pointlessaudio/PA_Telaio/hardware/prototipo-veroboard-seed3.html

# Prototipo su veroboard

Daisy Seed3 su zoccolo, due TLC2272 in DIP-8 a 9 V, ingresso e uscita stereo a livello strumento. Bypass in DSP su K1 e true bypass con footswitch 3PDT; i controlli sono cablati fuori scheda. Layout verificato da script: ogni net elettrica corrisponde a una sola isola di rame, nessun corto, nessun aperto.

Prima di saldare

1. Fai tutti i 57 tagli e controllali con il tester in continuità. Il taglio sulla colonna 7, righe 1–20, è quello che separa le due file del Seed: senza, il 3V3A va in corto con AGND e i 9 V finiscono su un GPIO.
2. Verifica sulla serigrafia del Seed3 dove sta il pin 1 e orienta gli header di conseguenza. Il puntino rosso nel disegno indica il pin 1.
3. Primo collaudo senza Seed e senza integrati negli zoccoli: misura VA, VB e VIN.

## Lato componenti

VA, alimentazione operazionali VB, bias a metà rail massa VIN Seed audio ponticello nudo taglio foro di fissaggio Ø 3,2

Strisce orizzontali viste in trasparenza. Linee continue: ponticelli sulla scheda, isolati tranne J1 e J2. Linee tratteggiate: cavetti isolati verso i pin del Seed, disegnati dritti per leggibilità: nella realtà falli girare intorno ai componenti. Cerchi verdi: piazzole per i fili che escono dalla scheda. Le resistenze che scavalcano una sola striscia vanno montate in piedi. D1 e R1 stanno sdraiati lungo la riga 22, a cavallo di un taglio.

## Lato rame, per i tagli

Vista dal lato rame, quindi specchiata: il foro 1 è a destra. I cerchi rossi sono i tagli, i fori chiari quelli dove va un terminale.

Fori di fissaggio, in blu nei due disegni: riga 2, fori 2 e 29; riga 38, foro 29; riga 44, foro 8. Da forare a 3,2 mm per viti M3, prima di montare i componenti. Stanno ad almeno un foro dal bordo e non spezzano strisce usate: layout.py lo controlla. Non usare la riga 45, l'ultima: la sua striscia porta la massa a R18 e alle masse delle uscite, e un foro lì sfonda il bordo.

Righe | Fori da tagliare | Perché
1–20 | 7, 15 | tra le due file del Seed, e accorcia le strisce di destra
22 | 5, 16 | isola jack DC, V9 e VIN
28–34 | 14 | centro dello zoccolo, separa canale sinistro e destro
37–44 | 14 | centro dello zoccolo, separa canale sinistro e destro

## Schema

### Alimentazione

### Ingresso, uno per canale

Tra parentesi i riferimenti del canale destro. Il guadagno è unitario: con una chitarra resti lontano dal fondo scala del Seed3, ma con 32 bit e il rumore di fondo del codec il margine perso non si sente.

### Uscita, una per canale

Lo stadio è invertente: in firmware moltiplica l'uscita per −1 per rimettere la fase in ordine.

## Componenti

Tipo | Valore | Q.tà | Riferimenti
Resistenza 1/4 W | 3R3 | 1 | R1
Resistenza 1/4 W | 10R | 1 | R2
Resistenza 1/4 W | 100R | 2 | R13, R17
Resistenza 1/4 W | 1K | 2 | R7, R10
Resistenza 1/4 W | 10K | 6 | R3, R4, R11, R12, R15, R16
Resistenza 1/4 W | 100K | 2 | R14, R18
Resistenza 1/4 W | 1M | 4 | R5, R6, R8, R9
Condensatore ceramico | 100pF | 2 | C19, C20
Condensatore ceramico | 390pF | 2 | C13, C16
Condensatore ceramico | 2.2nF | 2 | C6, C9
Condensatore ceramico | 100nF | 3 | C3, C11, C18
Condensatore a film | 100nF | 2 | C5, C8
Elettrolitico 16 V o più | 10µF | 6 | C7, C10, C12, C14, C15, C17
Elettrolitico 16 V o più | 47µF | 1 | C4
Elettrolitico 16 V o più | 100µF | 2 | C1, C2
Diodo Schottky | 1N5817 | 1 | D1
Operazionale DIP-8 | TLC2272 | 2 | U1, U2
Zoccolo | DIP-8 | 2 | U1, U2
Header femmina | 1×20, passo 2,54 | 2 | per il Seed3
Stripboard | almeno 30 fori × 45 strisce | 1
Jack 6,35 mm mono | boccola 3/8" | 4 | IN L e IN R con commutazione sulla punta; OUT L, OUT R
Jack DC 2,1 mm | centro negativo | 1
LED 3 mm + resistenza | 1K | 1 | fuori scheda, resistenza in linea
Filo isolato | unipolare 0,25 mm² | 1 | ponticelli J3-J13 e cavi W1-W7
Cavetto schermato | | 1 | ingressi e uscite verso i jack

## Cablaggio

### Piazzole verso l'esterno

Piazzola | Posizione | Cosa collegare
DC +9V | riga 22, foro 1 | Jack DC: +9 V (manicotto)
DC GND | riga 23, foro 1 | Jack DC: massa (centrale)
IN L | riga 32, foro 1 | Da Rs del jack IN L (INST/LINE)
IN L GND | riga 35, foro 1 | Jack IN L: manicotto
IN R | riga 34, foro 30 | Da Rs del jack IN R (INST/LINE)
IN R GND | riga 35, foro 30 | Jack IN R: manicotto
OUT L | riga 42, foro 1 | 3PDT polo A, posizione effetto
OUT L GND | riga 45, foro 1 | Jack OUT L: manicotto
OUT R | riga 42, foro 30 | 3PDT polo B, posizione effetto
OUT R GND | riga 45, foro 30 | Jack OUT R: manicotto
FS1 | riga 1, foro 1 | Tasto K1 (e pedale esterno, punta)
ENC A | riga 4, foro 1 | Encoder A
SD D0 | riga 5, foro 1 | microSD DAT0
SD CMD | riga 6, foro 1 | microSD CMD
SD CK | riga 7, foro 1 | microSD CLK
ENC B | riga 8, foro 1 | Encoder B
ENC SW | riga 9, foro 1 | Encoder pulsante
LED | riga 10, foro 1 | LED anodo tramite 1K
FS2 | riga 11, foro 1 | Tasto K2 (e pedale esterno, anello)
SCL | riga 12, foro 1 | OLED SCL
SDA | riga 13, foro 1 | OLED SDA
MIDI TX | riga 14, foro 1 | MIDI OUT verso scheda I/O
MIDI RX | riga 15, foro 1 | MIDI IN da scheda I/O
POT GND | riga 20, foro 3 | Pot 1-6: capo basso
CTRL GND | riga 1, foro 11 | Masse digitali: FS, encoder, LED
OLED GND | riga 1, foro 12 | OLED GND
IO GND | riga 1, foro 13 | Massa scheda I/O esterna
3V3D | riga 3, foro 13 | OLED VCC
IO 3V3D | riga 3, foro 14 | Alimentazione scheda I/O esterna
VA EXT | riga 37, foro 15 | VA verso schedina preamp e LED del bypass (R sul 3PDT); intrecciato con PRE GND
PRE GND | riga 35, foro 16 | Massa della schedina preamp, intrecciata con VA EXT
A5 | riga 14, foro 13 | Pot 6 cursore
A4 | riga 15, foro 13 | Pot 5 cursore
A3 | riga 16, foro 13 | Pot 4 cursore
A2 | riga 17, foro 13 | Pot 3 cursore
A1 | riga 18, foro 13 | Pot 2 cursore
A0 | riga 19, foro 13 | Pot 1 cursore
3V3A | riga 20, foro 13 | Pot 1-6: capo alto

### Ponticelli e cavetti

Nome | Riga/foro | Net
J1 | 28/12 → 29/12 | nudo
J2 | 29/17 → 30/17 | nudo
J3 | 28/18 → 25/18 | VA
J4 | 28/19 → 37/19 | VA
J5 | 31/5 → 35/5 | GND
J6 | 26/7 → 35/7 | GND
J7 | 23/29 → 26/29 | GND
J8 | 24/30 → 27/30 | VB
J9 | 27/29 → 36/29 | VB
J10 | 39/11 → 36/11 | VB
J11 | 40/21 → 36/21 | VB
J12 | 40/12 → 35/12 | GND
J13 | 40/2 → 45/2 | GND
W1 | 22/30 → 2/13 | VIN → pin 39
W2 | 23/2 → 20/2 | massa → AGND pin 20
W3 | 23/28 → 1/14 | massa → DGND pin 40
W4 | 34/1 → 16/1 | → IN 1 pin 16
W5 | 33/15 → 17/2 | → IN 2 pin 17
W6 | 44/1 → 18/1 | OUT 1 pin 18 →
W7 | 44/15 → 19/2 | OUT 2 pin 19 →

Encoder e tasti chiudono verso massa: attiva i pull-up interni in firmware. Le masse dei controlli digitali si uniscono fuori scheda e arrivano tutte alla piazzola CTRL.

## Scheda I/O posteriore e cablaggi esterni

Non è sulla veroboard: cablaggi per la schedina che porta MIDI, microSD, il deviatore INST/LINE e il jack pedale. Alimentazione dalle piazzole IO 3V3D / IO GND.

### MIDI IN — jack TRS 3,5 mm tipo A

Nodo | Collegato a
Anello (pin 4 DIN) | 220 Ω → anodo LED optoaccoppiatore H11L1M (pin 1)
Punta (pin 5 DIN) | catodo LED opto H11L1M (pin 2)
1N4148 | antiparallelo sul LED, catodo verso il pin 1
H11L1M pin 6 | +3V3D (piazzola IO 3V3D)
H11L1M pin 5 | GND (piazzola IO GND)
H11L1M pin 4 (uscita) | piazzola "MIDI RX", pull-up 270 Ω a +3V3D
100 nF | tra +3V3D e GND, vicino all'opto
Manica jack | GND tramite 100 nF, non diretto

Come da datasheet Seed3, fig. 7.1 e 7.3. L'opto isola la massa MIDI dalla massa audio; il diodo protegge il LED dalla polarità inversa del loop di corrente MIDI.

### MIDI OUT — jack TRS 3,5 mm tipo A

Nodo | Collegato a
Piazzola "MIDI TX" | 10 Ω → punta
+3V3D | 10 Ω → anello
Manica jack | GND

Come da datasheet Seed3, fig. 7.5: uscita a livello logico 3,3 V, senza opto, solo i due resistori di corrente.

### microSD, modalità 1-bit

Pin Seed | Pin scheda SD | Pull-up a +3V3D
D4 (piazzola "SD D0") | DAT0 | 47 kΩ
D5 (piazzola "SD CMD") | CMD | 47 kΩ
D6 (piazzola "SD CK") | CLK | nessuno
— (non collegato) | DAT1 | 47 kΩ
— (non collegato) | DAT2 | 47 kΩ
— (non collegato) | DAT3 | 47 kΩ

Come da datasheet Seed3, fig. 5.1. Alimentazione dalle piazzole IO 3V3D / IO GND. DAT1-DAT3 restano con pull-up sulla scheda SD ma non arrivano al Seed: modalità 1-bit, si leggono solo DAT0/CMD/CLK.

### Deviatore INST/LINE

DPDT sul pannello posteriore, un polo per canale. In serie tra la punta del jack d'ingresso e la piazzola IN L / IN R della scheda: Rs = 10 kΩ, sempre inserita. Dal lato scheda di Rs, Rsh = 3,3 kΩ verso GND attraverso il polo del deviatore.

Deviatore | Modo | Attenuazione | Impedenza d'ingresso
chiuso | LINE | −12 dB | ~13 kΩ
aperto | INST | 0 dB | ~1 MΩ

I due poli restano separati: un solo polo su entrambi i canali metterebbe in diafonia i due ingressi a deviatore aperto. Il jack d'ingresso deve avere il contatto di commutazione della punta verso GND, così a jack scollegato l'ingresso non fruscia.

### Jack TRS 6,35 mm "pedale"

In parallelo ai tasti K1 e K2 sul pannello (vedi Piazzole verso l'esterno, FS1/FS2): punta = D0 (K1, bypass), anello = D10 (K2, mono), manica = GND.

### True bypass stereo — footswitch 3PDT

Sul pannello superiore, in basso a destra. Due poli scambiano le uscite fra effetto e ingresso diretto, il terzo accende il LED accanto al footswitch. I nomi dei terminali seguono la funzione: sul 3PDT la fila centrale sono i comuni, le due file esterne le due posizioni.

Polo | Comune | Posizione "effetto" | Posizione "bypass"
A (sinistro) | punta jack OUT L | piazzola OUT L | punta jack IN L, prima di Rs
B (destro) | punta jack OUT R | piazzola OUT R | punta jack IN R, prima di Rs
C (LED) | VA tramite 4,7 kΩ saldata sul terminale | anodo LED bypass | libero

VA arriva dalla piazzola VA EXT; catodo del LED bypass alla massa più vicina (circa 1,5 mA con un LED rosso): acceso a effetto inserito. Come in case/cablaggio.md (29/10). In bypass l'ingresso resta collegato anche al buffer da 1 MΩ, che non carica il segnale; il deviatore INST/LINE agisce solo sul ramo effetto. R14/R18 da 100 kΩ tengono a massa i condensatori d'uscita: niente colpo alla commutazione. Il bypass in DSP su K1 resta, per gli effetti con code che devono sfumare. Il polo C porta VA (8,5 V): non collegarlo a un pin del Seed per leggere lo stato del 3PDT.

### Componenti fuori scheda

Tipo | Valore | Q.tà | Note
OLED I2C | 2,42", 128×64, SSD1309 | 1 | molti moduli escono in SPI: sposta il ponticello I2C sul modulo
Tasto tattile 12×12 | cappuccio tondo | 2 | K1, K2
Encoder | Bourns PEC11R | 1 | con pulsante
Potenziometro | Alpha 9 mm, 10K lineare | 6
Optoaccoppiatore | H11L1M | 1 | MIDI IN
Diodo | 1N4148 | 1 | MIDI IN, antiparallelo al LED
Resistenza | 220 Ω | 1 | MIDI IN, serie LED
Resistenza | 270 Ω | 1 | MIDI IN, pull-up uscita opto
Resistenza | 10 Ω | 2 | MIDI OUT
Resistenza | 47 kΩ | 5 | pull-up microSD: DAT0, DAT1, DAT2, DAT3, CMD
Resistenza | 10 kΩ | 2 | Rs deviatore INST/LINE, un canale ciascuna
Resistenza | 3,3 kΩ | 2 | Rsh deviatore INST/LINE, un canale ciascuna
Condensatore ceramico | 100 nF | 2 | decoupling opto, manica MIDI IN
Deviatore | DPDT | 1 | INST/LINE, pannello posteriore
Jack TRS 3,5 mm | | 2 | MIDI IN, MIDI OUT
Jack TRS 6,35 mm | | 1 | pedale esterno, in parallelo a K1/K2
Lettore microSD | | 1 | slot o modulo breakout
Footswitch | 3PDT, 9 terminali, boccola M12 | 1 | true bypass stereo, pannello superiore
LED | 3 mm | 1 | stato del bypass, accanto al footswitch
Resistenza | 1 kΩ | 1 | LED bypass, da +3V3D

## Collaudo

1. Continuità: ogni taglio aperto, nessun corto tra VA, VB, VIN e massa.
2. Alimenta a 9 V senza integrati e senza Seed. VA intorno a 8,6 V, VB metà di VA, VIN uguale a VA meno qualche decimo.
3. Inserisci U1 e U2. Le uscite dei quattro operazionali a riposo devono stare su VB.
4. Inserisci il Seed3 e carica un passthrough. Segnale in, segnale out, niente altro.
5. Solo dopo, collega pot, encoder, OLED, tasti e footswitch, uno alla volta.

## Limiti da conoscere

U1 e U2 sono TLC2272 al posto del TL072: il TL072 ha il modo comune d'ingresso che parte ~3 V sopra la massa, quindi l'inseguitore d'ingresso a VB ≈ 4,3 V arrivava solo a ~2,6 Vpp contro i 3,6 Vpp di fondo scala del codec; il TLC2272 accetta da 0 V a 1,5 V sotto il positivo, ~5,5 Vpp intorno a VB. Rumore 9 nV/√Hz, il doppio dell'OPA1652 dei circuiti del datasheet Seed3 (che è solo SMD): con una chitarra collegata domina il rumore dei pickup. Con una sorgente di linea molto calda il segnale può comunque superare il fondo scala del Seed3 attraverso il buffer a guadagno unitario: in quel caso metti un partitore prima di J IN.

Il rumore sarà peggiore di un PCB a quattro strati con piano di massa. Cavetto schermato su ingressi e uscite, fili dei pot corti e lontani dal Seed, e hai fatto quello che il veroboard permette.
