pointlessaudio/PA_Telaio/docs/storico/PA-TELAIO_BOM.xlsx

Rif. | Q.tà | Componente / Valore | Package | Sezione | Note
J1 | 1 | Jack DC 2.1 mm, center-negative, PCB | THT | Alimentazione | Tipo Boss, 9 V
D1 | 1 | NSR1020MW2T3G (Schottky) | SOD-323 | Alimentazione | Protezione inversione — datasheet Fig. 1.1
R1, R2 | 2 | 3R3, 1/4 W | THT | Alimentazione | Filtro serie rail — datasheet Fig. 1.1
C1-C4 | 4 | 100 uF elettrolitico, 25 V | THT | Alimentazione | Bulk 9V / 9V_A / VIN
C5, C6 | 2 | 100 nF X7R | 0805 | Alimentazione | Bypass
U1 | 1 | 78L05 | TO-92 | Alimentazione | Rail +5 V per expression, CV, relè
C7 | 1 | 10 uF elettrolitico | THT | Alimentazione | Ingresso 78L05
C8 | 1 | 100 nF X7R | 0805 | Alimentazione | Uscita 78L05
U2 | 1 | MCP6002 (dual) | SOIC-8 | Riferimento bias | Datasheet Fig. 3.1 — U2B libero su header
R3, R4 | 2 | 10K 1% | 0805 | Riferimento bias | Partitore da +9V_A
R5 | 1 | 10K | 0805 | Riferimento bias | Carico permanente uscita buffer
C9 | 1 | 10 uF | THT | Riferimento bias
C10 | 1 | 100 nF X7R | 0805 | Riferimento bias
C11 | 1 | 100 uF elettrolitico | THT | Riferimento bias
J2, J3 | 2 | Jack 6.3 mm mono switched, PCB | THT | Ingresso | IN L / IN R, R normalizzato su L
U3, U4 | 2 | OPA1652 (dual) | SOIC-8 | Ingresso | Uno per canale — datasheet Fig. 3.4
R6, R7 | 2 | 1M | 0805 | Ingresso | Impedenza ingresso 1 MΩ
R8, R9 | 2 | 100R | 0805 | Ingresso | Serie protezione
C12, C13 | 2 | 100 pF C0G | 0805 | Ingresso | Filtro RF
C14, C15 | 2 | 10 uF elettrolitico | THT | Ingresso | Accoppiamento ingresso
R10, R11 | 2 | 3K3 | 0805 | Ingresso | Filtro anti-alias
C16, C17 | 2 | 1 nF C0G | 0805 | Ingresso | Filtro anti-alias ~48 kHz
R12, R13 | 2 | 4K7 | 0805 | Ingresso
C18, C19 | 2 | 33 nF | 0805 | Ingresso
R14, R15 | 2 | 10K | 0805 | Ingresso | Rete secondo stadio
C20, C21 | 2 | 330 pF C0G | 0805 | Ingresso
R16, R17 | 2 | 100R | 0805 | Ingresso | Serie verso Audio In del Seed3
C22, C23 | 2 | 10 uF elettrolitico | THT | Ingresso | Accoppiamento verso Seed3
R18, R19 | 2 | 33K | 0805 | Ingresso | SCELTA DI PROGETTO — Rf guadagno, da tarare a banco
R20, R21 | 2 | 8K2 | 0805 | Ingresso | SCELTA DI PROGETTO — Rg, guadagno ~x5
SW1 | 1 | Toggle DPDT ON-ON | THT | Ingresso | Strumento / Linea, commuta entrambi i canali
U5 | 1 | OPA1652 (dual) | SOIC-8 | Uscita | Un op-amp per canale — datasheet Fig. 3.5
R22, R23 | 2 | 15K | 0805 | Uscita
R24, R25 | 2 | 33K | 0805 | Uscita
C24, C25 | 2 | 100 pF C0G | 0805 | Uscita
C26, C27 | 2 | 10 uF elettrolitico | THT | Uscita | Accoppiamento da Audio Out
C28, C29 | 2 | 10 uF elettrolitico | THT | Uscita | Accoppiamento verso jack
R26, R27 | 2 | 10K | 0805 | Uscita | Scarica anti-pop
R28, R29 | 2 | 100R | 0805 | Uscita | Impedenza di uscita
J4, J5 | 2 | Jack 6.3 mm mono, PCB | THT | Uscita | OUT L / OUT R
K1 | 1 | Relè DPDT latching 5 V, doppia bobina | THT | Bypass | DA VERIFICARE disponibilità e impulso minimo
Q1, Q2 | 2 | MMBT3904 | SOT-23 | Bypass | Driver set / reset
R30, R31 | 2 | 10K | 0805 | Bypass | Base transistor
D2, D3 | 2 | 1N4148 | SOD-123 | Bypass | Flyback bobine
RV1-RV6 | 6 | Potenziometro 10K lin, PCB verticale 9 mm | THT | Controlli | Datasheet Fig. 4.1, su +3V3A
ENC1 | 1 | Encoder rotativo 24 detent con pulsante | THT | Controlli | Es. PEC11R-4215F-S0024
SW2, SW3 | 2 | Footswitch momentaneo SPST soft-touch | THT | Controlli | Non latching: lo stato lo gestisce il firmware
D4 | 1 | LED RGB catodo comune 5 mm | THT | Controlli | Tre canali PWM
R32-R34 | 3 | 2K2 | 0805 | Controlli | Limitazione LED
OLED1 | 1 | Display OLED 128x64 I2C SSD1306 | Modulo | Display | Su header 4 pin, +3V3D
R41, R42 | 2 | 4K7 | 0805 | Display | Pull-up I2C
J6 | 1 | Jack 6.3 mm TRS, PCB | THT | Expression / CV | Expression pedal
J7, J8 | 2 | Jack 3.5 mm TS, PCB | THT | Expression / CV | CV in 1 / 2, -5 / +5 V
U6 | 1 | MCP6004 (quad) | SOIC-14 | Expression / CV | Rail-to-rail su +3V3A, fa da clamp
R43, R44 | 2 | 33K | 0805 | Expression / CV | Expression — datasheet Fig. 4.5
R45, R46 | 2 | 100K | 0805 | Expression / CV | Partitore riferimento
C30 | 1 | 1 nF C0G | 0805 | Expression / CV
R47, R48 | 2 | 1M | 0805 | Expression / CV | CV — datasheet Fig. 4.4
R49, R50 | 2 | 10K | 0805 | Expression / CV | CV, rete di feedback
R51, R52 | 2 | 10K | 0805 | Expression / CV | CV, partitore su +5V
R53, R54 | 2 | 20K | 0805 | Expression / CV | CV, partitore su +5V
R55, R56 | 2 | 100R | 0805 | Expression / CV | CV, serie verso ADC
C31, C32 | 2 | 10 nF | 0805 | Expression / CV | CV, filtro
J9, J10 | 2 | Jack 3.5 mm TRS, PCB | THT | MIDI | MIDI IN / OUT tipo A
U7 | 1 | H11L1M (optoaccoppiatore Schmitt) | DIP-6 | MIDI | Datasheet Fig. 7.1
R57 | 1 | 220R | 0805 | MIDI | MIDI IN, limitazione LED optoaccoppiatore
R58 | 1 | 270R | 0805 | MIDI | MIDI IN, pull-up uscita
C33 | 1 | 100 nF X7R | 0805 | MIDI
R59, R60 | 2 | 10R | 0805 | MIDI | MIDI OUT — datasheet Fig. 7.5
SD1 | 1 | Socket microSD push-push | SMD | microSD | Modo 1-bit
R61, R62 | 2 | 47K | 0805 | microSD | Pull-up CMD e DAT0 — datasheet Fig. 5.1
C34 | 1 | 100 nF X7R | 0805 | microSD | Bypass alimentazione SD
A1 | 1 | Daisy Seed3 | Modulo | Meccanica | Su zoccolo, mai saldato
H1, H2 | 2 | Header femmina 1x20, 2.54 mm, tornito | THT | Meccanica | Zoccolo Seed3, passo 0.6"
H3 | 1 | Header maschio 2x6, 2.54 mm | THT | Meccanica | Espansione GPIO / ADC / DAC / rail
H4 | 1 | Header maschio 1x4, 2.54 mm | THT | Meccanica | Op-amp U2B libero
ENC-1 | 6 | Manopola per pot 6 mm | - | Meccanica
ENC-2 | 1 | Manopola per encoder | - | Meccanica
BOX1 | 1 | Contenitore Hammond 1590DD (o superiore) | - | Meccanica | DA VERIFICARE il fit: 6 pot + OLED + 2 footswitch
MISC | 1 | Distanziali, viti M3, dadi jack | - | Meccanica | Kit
TOTALE PEZZI | 140
Riferimenti circuitali: Daisy Seed3 Datasheet v2.1.0 (Qu-Bit Electronix / Daisy), figure 1.1, 3.1, 3.4, 3.5, 4.1, 4.4, 4.5, 5.1, 7.1, 7.5.
Le voci marcate SCELTA DI PROGETTO non provengono dal datasheet: sono valori proposti, da verificare a banco prima del layout.
Le voci marcate DA VERIFICARE richiedono una scelta di componente reale (disponibilità, specifiche meccaniche) non ancora fatta.
Prezzi non inclusi: variano per distributore e quantità. Da compilare al momento dell'ordine.
