pointlessaudio/PA_Telaio/docs/storico/PA_ordine_125b_Seed3.xlsx

Sheet: Ordine
# | Fase | Voce | Q.tà | Fornitore | Riferimento / Link | Prezzo unit. (EUR) | Totale (EUR) | Fatto | Note
1 | 0 - Da fare subito | Pre-ordine relè CPC1018 nel Parts Manager JLCPCB (alternativa: CPC1019) | 6 | JLCPCB Parts Manager | https://jlcpcb.com/user-center/smtPrivateLibrary/ |  |  |  | Part # C133069 o C1558973 (CPC1018); alternative C1854946 o C2760117 (CPC1019). Serve 1-2 settimane per entrare in libreria: BLOCCA tutto il resto. Q.tà 6 = 5 schede + 1 scorta.
2 | 1 - PCB | Download gerber Rev6 (zip, NON scompattare) | 1 | GitHub | https://github.com/bkshepherd/DaisySeedProjects/blob/main/Hardware/GuitarPedal125b/pcb/JLCPCB-Gerbers/DaisySeedPedal125b-Rev6-gerbers.zip |  |  |  | Gratis
3 | 1 - PCB | Download BOM JLCSMT (.xlsx) | 1 | GitHub | https://github.com/bkshepherd/DaisySeedProjects/blob/main/Hardware/GuitarPedal125b/pcb/BOM_JLCSMT_DaisySeedGuitarPedal125b.xlsx |  |  |  | Gratis
4 | 1 - PCB | Download centroid / CPL (.csv) | 1 | GitHub | https://github.com/bkshepherd/DaisySeedProjects/blob/main/Hardware/GuitarPedal125b/pcb/JLCPCB-Gerbers/DaisySeedPedal125b-top-pos.csv |  |  |  | Gratis
5 | 1 - PCB | Ordine 5 PCB assemblate (minimo d'ordine JLCPCB) | 5 | JLCPCB | https://www.jlcpcb.com |  |  |  | Opzioni: finitura ENIG (non HASL), Confirm Production File, PCB Assembly ON, solo lato TOP, Confirm Parts Placement. Alla conferma BOM/CPL devi vedere 28 parti rilevate e 28 confermate.
6 | 1 - PCB | Far montare a JLCPCB anche i 2 header 20 pin (opzione in assemblaggio) | 1 | JLCPCB | - |  |  |  | Consigliato: risparmia 40 saldature a mano. Se lo fai, salta la riga header sotto.
7 | 2 - Parti da saldare a mano | Header femmina 20 pin, passo 2.54, torniti | 2 | TME / Mouser | - |  |  |  | Solo se NON li fa montare JLCPCB. Vanno sul lato con gli SMD.
8 | 2 - Parti da saldare a mano | Potenziometro Alpha RD901F-40-15R1-B10K, 10K lin, 9mm PCB | 6 | Tayda / Musikding / Banzai | https://www.taydaelectronics.com/10k-ohm-linear-taper-potentiometer-round-shaft-pcb-9mm.html |  |  |  | TRAPPOLA: i distanziali metallici dei pot 4-6 toccano i pin degli header Daisy. Vanno tagliati dal lato vicino ai pin, altrimenti corto.
9 | 2 - Parti da saldare a mano | Encoder rotativo Bourns PEC11R-4220K-S24 | 1 | Mouser / TME | https://www.mouser.com/ProductDetail/652-PEC11R-4220K-S24 |  |  |  | Magazzino europeo disponibile su entrambi.
10 | 2 - Parti da saldare a mano | Display OLED 0.96" 128x64 I2C SSD1306 | 1 | TME / Amazon IT | - |  |  |  | Si salda con il SUO header, non con uno zoccolo femmina sul PCB. Servono distanziali esagonali nylon M2 da 6mm per allinearlo al pannello.
11 | 2 - Parti da saldare a mano | LED 3mm (colore a piacere) | 2 | Musikding / Tayda | - |  |  |  | Gambe da accorciare per allinearsi al contenitore. Pin corto sulla piazzola quadrata.
12 | 2 - Parti da saldare a mano | Footswitch momentaneo SPST, normalmente aperto | 2 | Musikding / Banzai | - |  |  |  | Momentanei, NON latching: il bypass lo gestisce il relè via firmware.
13 | 2 - Parti da saldare a mano | Distanziali esagonali nylon M2 6mm per OLED | 4 | TME / Mouser | -
14 | 3 - Contenitore | Contenitore 125B forato su misura e verniciato | 1 | Tayda (template pronto) | https://drill.taydakits.com/box-designs/new?public_key=MlRHaUhqaEVXOVVFZ1ErV1FiTXlrQT09Cg== |  |  |  | Alternativa: file STEP e FreeCAD nel repo, cartella enclosure, per stampa 3D o fresatura locale (niente dazi).
15 | 3 - Contenitore | Manopola per potenziometro, albero liscio 6mm | 6 | Musikding / Banzai / Tayda | -
16 | 3 - Contenitore | Manopola per encoder | 1 | Musikding / Banzai | -
17 | 3 - Contenitore | Portaled da pannello 3mm | 2 | Musikding / Banzai | -
18 | 4 - Già in tuo possesso | Daisy Seed3 | 1 | daisy.audio | https://daisy.audio/products/seed3 |  |  |  | Già acquistato. Listino 29,99 USD se ne servisse un secondo.
19 | 4 - Già in tuo possesso | Cavo USB-C per flashare | 1 | - | - |  |  |  | Il Seed3 ha USB-C onboard: niente più micro-USB.
20 | 5 - Extra opzionali | Alimentatore 9V center-negative isolato | 1 | Musikding / Thomann | - |  |  |  | L'autore ha tolto l'isolatore DC-DC dalla Rev6 contando su un'alimentazione già isolata. Non usare un alimentatore scadente.
21 | 5 - Extra opzionali | Scorta componenti SMD critici per riparazioni | 1 | TME / Mouser | - |  |  |  | Facoltativo.
 |  |  |  |  |  | TOTALE | 0.00
LEGENDA - le celle in blu su sfondo giallo sono quelle da compilare: Q.tà, Prezzo unit., Fatto.
La colonna Totale si calcola da sola (Q.tà x Prezzo unit.) e resta vuota finché non inserisci un prezzo.
Esempio di riga compilata: Q.tà 6, Prezzo unit. 1,20 -> Totale 7,20.
Nessun prezzo è precompilato: variano per fornitore, quantità e cambio. Da verificare al momento dell'ordine.
Spedizioni da JLCPCB (Cina) e Tayda (Thailandia): calcola IVA all'importazione ed eventuali dazi.
Fornitori senza dogana per l'Italia: TME (PL), Mouser (magazzino EU), Musikding e Banzai (DE), Thomann (DE).

Sheet: Verifiche Seed3
# | Verifica | Perché | Esito
1 | Compatibilità elettrica | Daisy dichiara il Seed3 pin-to-pin compatibile con l'hardware Seed esistente, senza modifiche al circuito esterno. L'Hothouse è già dichiarato Seed3 compatible. Quindi il PCB Rev6 non va modificato.
2 | Accesso meccanico alla USB | Il Seed3 ha USB-C al posto della micro-USB. Il PCB Rev6 prevede accesso alla porta USB e ai pulsanti di reset: verificare che il taglio del contenitore e la posizione della porta coincidano. È il punto di rischio più concreto.
3 | Profilo più basso | Il Seed3 ha l'header JTAG non popolato ed è più basso: gioca a favore, non contro, nello spazio sotto la scheda.
4 | Filtro RC in uscita | La Rev6 ha aggiunto un RC passa-basso dopo le uscite audio per il rumore fuori banda del Seed Rev7. Con il noise floor del Seed3 potrebbe non servire più, ma non fa danno: lasciarlo.
5 | Frequenza di campionamento | Qui sta il vero guadagno del Seed3, ed è tutto firmware: 32 bit fino a 192 kHz contro i 48 kHz tipici dei progetti Daisy esistenti. Il PCB non cambia, cambia il codice.
6 | Conferma dalla community | Prima di impegnarsi su 5 schede assemblate: chiedere sul Discord Daisy o sul forum se qualcuno ha già montato un Seed3 su un 125B Rev6.
