pointlessaudio/PA_Telaio/hardware/preamp/montaggio_preamp.html

# Preamp JFET d'ingresso su stripboard

Circuito V4a (risultati.md). Scheda 24 × 18 fori (61.0 × 45.7 mm), vista dai componenti: le strisce di rame sono sotto, orizzontali. X rossa = taglio della striscia, tratteggio verde = ponticello/cavo isolato, quadrato rosso = piazzola per filo esterno. Canale L in alto (righe 1-9), R in basso (righe 10-18, specchiato).

## J201 (TO-92)

Piedini: 1 = drain, 2 = source, 3 = gate (Central Semiconductor J201, lead code). Sulla scheda i tre piedi stanno su tre strisce consecutive: D, S, G (nel canale L dal basso verso l'alto; nel R dall'alto verso il basso, quindi il componente va girato di 180°). Verificare con il tester prima di saldare.

## Componenti

Riferimenti | N. | Valore | Montaggio
C1L, C1R | 2 | 47n film | 5 mm
Rg1L, Rg2L, Rg1R, Rg2R | 4 | 1M | giacente
Rstop1L, Rstop2L, Rstop1R, Rstop2R | 4 | 1k | orizzontale
J1L, J2L, J1R, J2R | 4 | J201 | TO-92
Rd1L, Rd1R | 2 | 27k | giacente
Rs1L, Rs1R | 2 | 22k | in piedi
R220_L, R220_R | 2 | 220R | orizzontale
Cs1L, Cs1R | 2 | 47u/16V 5x11 elco | 2,5 mm
C2L, C2R | 2 | 220n film | 5 mm
Rd2L, Rd2R | 2 | 20k | giacente
Rs2L, Rs2R | 2 | 15k | in piedi
C3L, C3R | 2 | 1u film | 5 mm (verificare passo)
TRL, TRR | 2 | 100k LEVEL (3296W) | in linea, passo 2,54
Rvt | 1 | 39k | in piedi
Rvb | 1 | 10k | in piedi
Cvg | 1 | 22u/16V 5x11 elco | 2,5 mm
CB | 1 | 100u/16V 6,3x11 elco (non simulato) | 2,5 mm
CD | 1 | 100n MLCC (non simulato) | 2,54 mm

## Piazzole esterne

GAIN: pot doppio 9 mm C50K usato come reostato (cursore e un capo), con una 47k saldata direttamente sui due terminali usati di ogni gang. A GAIN al massimo la resistenza va a zero: se il guadagno sale girando a sinistra, usare l'altro capo.

VA | riga 8 foro 1 | alimentazione analogica
GND | riga 9 foro 1 | massa: stella della scheda
IN L | riga 1 foro 1 | dal jack IN L
IN R | riga 18 foro 1 | dal jack IN R
OUT L | riga 8 foro 24 | verso il deviatore PRE, canale L
OUT R | riga 11 foro 24 | verso il deviatore PRE, canale R
GAIN A L | riga 4 foro 4 | pot GAIN L (doppio C50K), capo verso S1; 47k fra i due capi, sul pot
GAIN B L | riga 2 foro 4 | pot GAIN L, ritorno verso 220R
GAIN A R | riga 15 foro 4 | pot GAIN R (doppio C50K), capo verso S1; 47k fra i due capi, sul pot
GAIN B R | riga 17 foro 4 | pot GAIN R, ritorno verso 220R

## Ponticelli e cavi

J1 | riga 6 foro 8 → riga 9 foro 8 | GND_a L -> GND_b L
J2 | riga 13 foro 8 → riga 10 foro 8 | GND_a R -> GND_b R
J3 | riga 9 foro 7 → riga 10 foro 7 | GND_b L -> GND_b R
J4 | riga 7 foro 13 → riga 12 foro 13 | VG L -> VG R
J5 | riga 8 foro 14 → riga 11 foro 14 | VA L -> VA R
W1 | riga 1 foro 5 → riga 9 foro 2 | ritorno Cs1 L -> primo foro dopo il pad GND
W2 | riga 18 foro 5 → riga 9 foro 3 | ritorno Cs1 R -> secondo foro dopo il pad GND

## Tagli (18)

riga 1 | foro 4
riga 2 | foro 7
riga 3 | foro 5
riga 3 | foro 10
riga 3 | foro 15
riga 4 | foro 11
riga 5 | foro 12
riga 7 | foro 19
riga 8 | foro 22
riga 11 | foro 22
riga 12 | foro 19
riga 14 | foro 12
riga 15 | foro 11
riga 16 | foro 5
riga 16 | foro 10
riga 16 | foro 15
riga 17 | foro 7
riga 18 | foro 4

## Fori di fissaggio M3 (3,2 mm)

riga 2 foro 22; riga 17 foro 22. Forare prima di montare.
