pointlessaudio/PA_Telaio/hardware/kicad/f01_alimentazione.kicad_sch

## KiCad design hardware/kicad/f01_alimentazione.kicad_sch (2026-10-29)

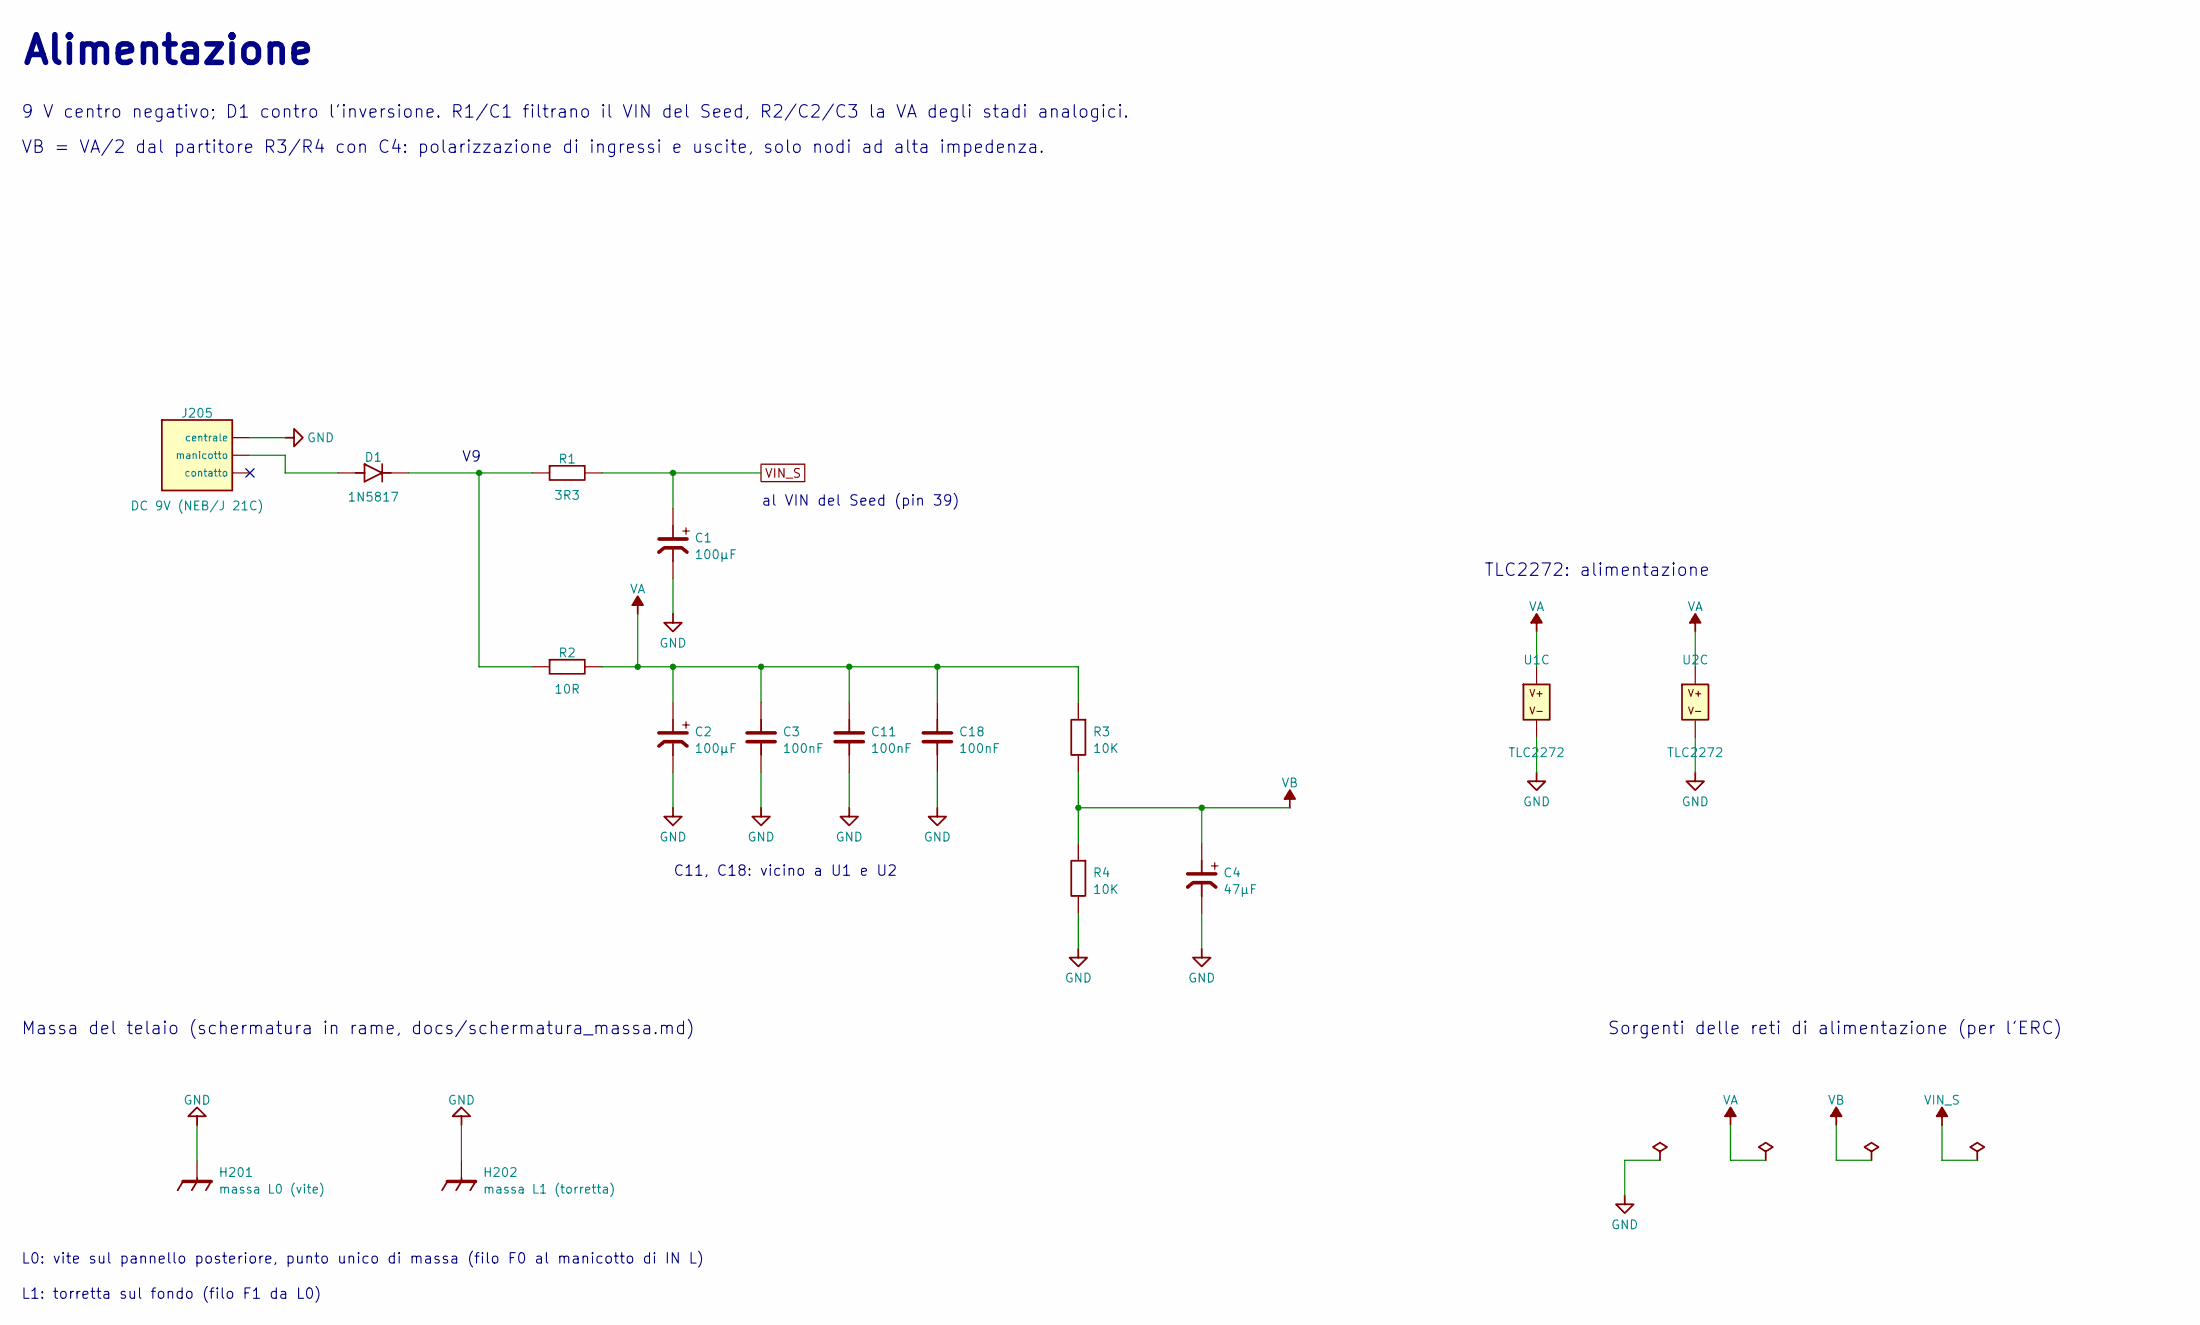
[picture p14: schematic f01_alimentazione.kicad_sch]

Parts:
C1, C2: 100µF; CP_Radial_D5.0mm_P2.50mm
C3, C11, C18: 100nF; C_Disc_D5.0mm_W2.5mm_P5.00mm
C4: 47µF; CP_Radial_D5.0mm_P2.50mm
D1: 1N5817; D_DO-41_SOD81_P10.16mm_Horizontal
H201: massa L0 (vite)
H202: massa L1 (torretta)
J205: DC 9V (NEB/J 21C)
R1: 3R3; R_Axial_DIN0207_L6.3mm_D2.5mm_P7.62mm_Horizontal
R2: 10R; R_Axial_DIN0207_L6.3mm_D2.5mm_P7.62mm_Horizontal
R3, R4: 10K; R_Axial_DIN0207_L6.3mm_D2.5mm_P7.62mm_Horizontal
U1, U2: TLC2272; DIP-8_W7.62mm_Socket

Connections:
GND: C1.2 (-), C2.2 (-), C3.2, C4.2 (-), C11.2, C18.2, H201.1, H202.1, J205.1 (centrale), R4.2, U1.4 (V-), U2.4 (V-)
unnamed: D1.1 (K), R1.1, R2.1
unnamed: D1.2 (A), J205.2 (manicotto)
VA: C2.1 (+), C3.1, C11.1, C18.1, R2.2, R3.1, U1.8 (V+), U2.8 (V+)
VB: C4.1 (+), R3.2, R4.1
VIN_S: C1.1 (+), R1.2

Notes on the sheet:
Alimentazione
9 V centro negativo; D1 contro l'inversione. R1/C1 filtrano il VIN del Seed, R2/C2/C3 la VA degli stadi analogici.
VB = VA/2 dal partitore R3/R4 con C4: polarizzazione di ingressi e uscite, solo nodi ad alta impedenza.
al VIN del Seed (pin 39)
C11, C18: vicino a U1 e U2
TLC2272: alimentazione
Massa del telaio (schermatura in rame, docs/schermatura_massa.md)
L0: vite sul pannello posteriore, punto unico di massa (filo F0 al manicotto di IN L)
L1: torretta sul fondo (filo F1 da L0)
Sorgenti delle reti di alimentazione (per l'ERC)
