pointlessaudio/PA_Telaio/hardware/kicad/f02_ingressi.kicad_sch

## KiCad design hardware/kicad/f02_ingressi.kicad_sch (2026-10-29)

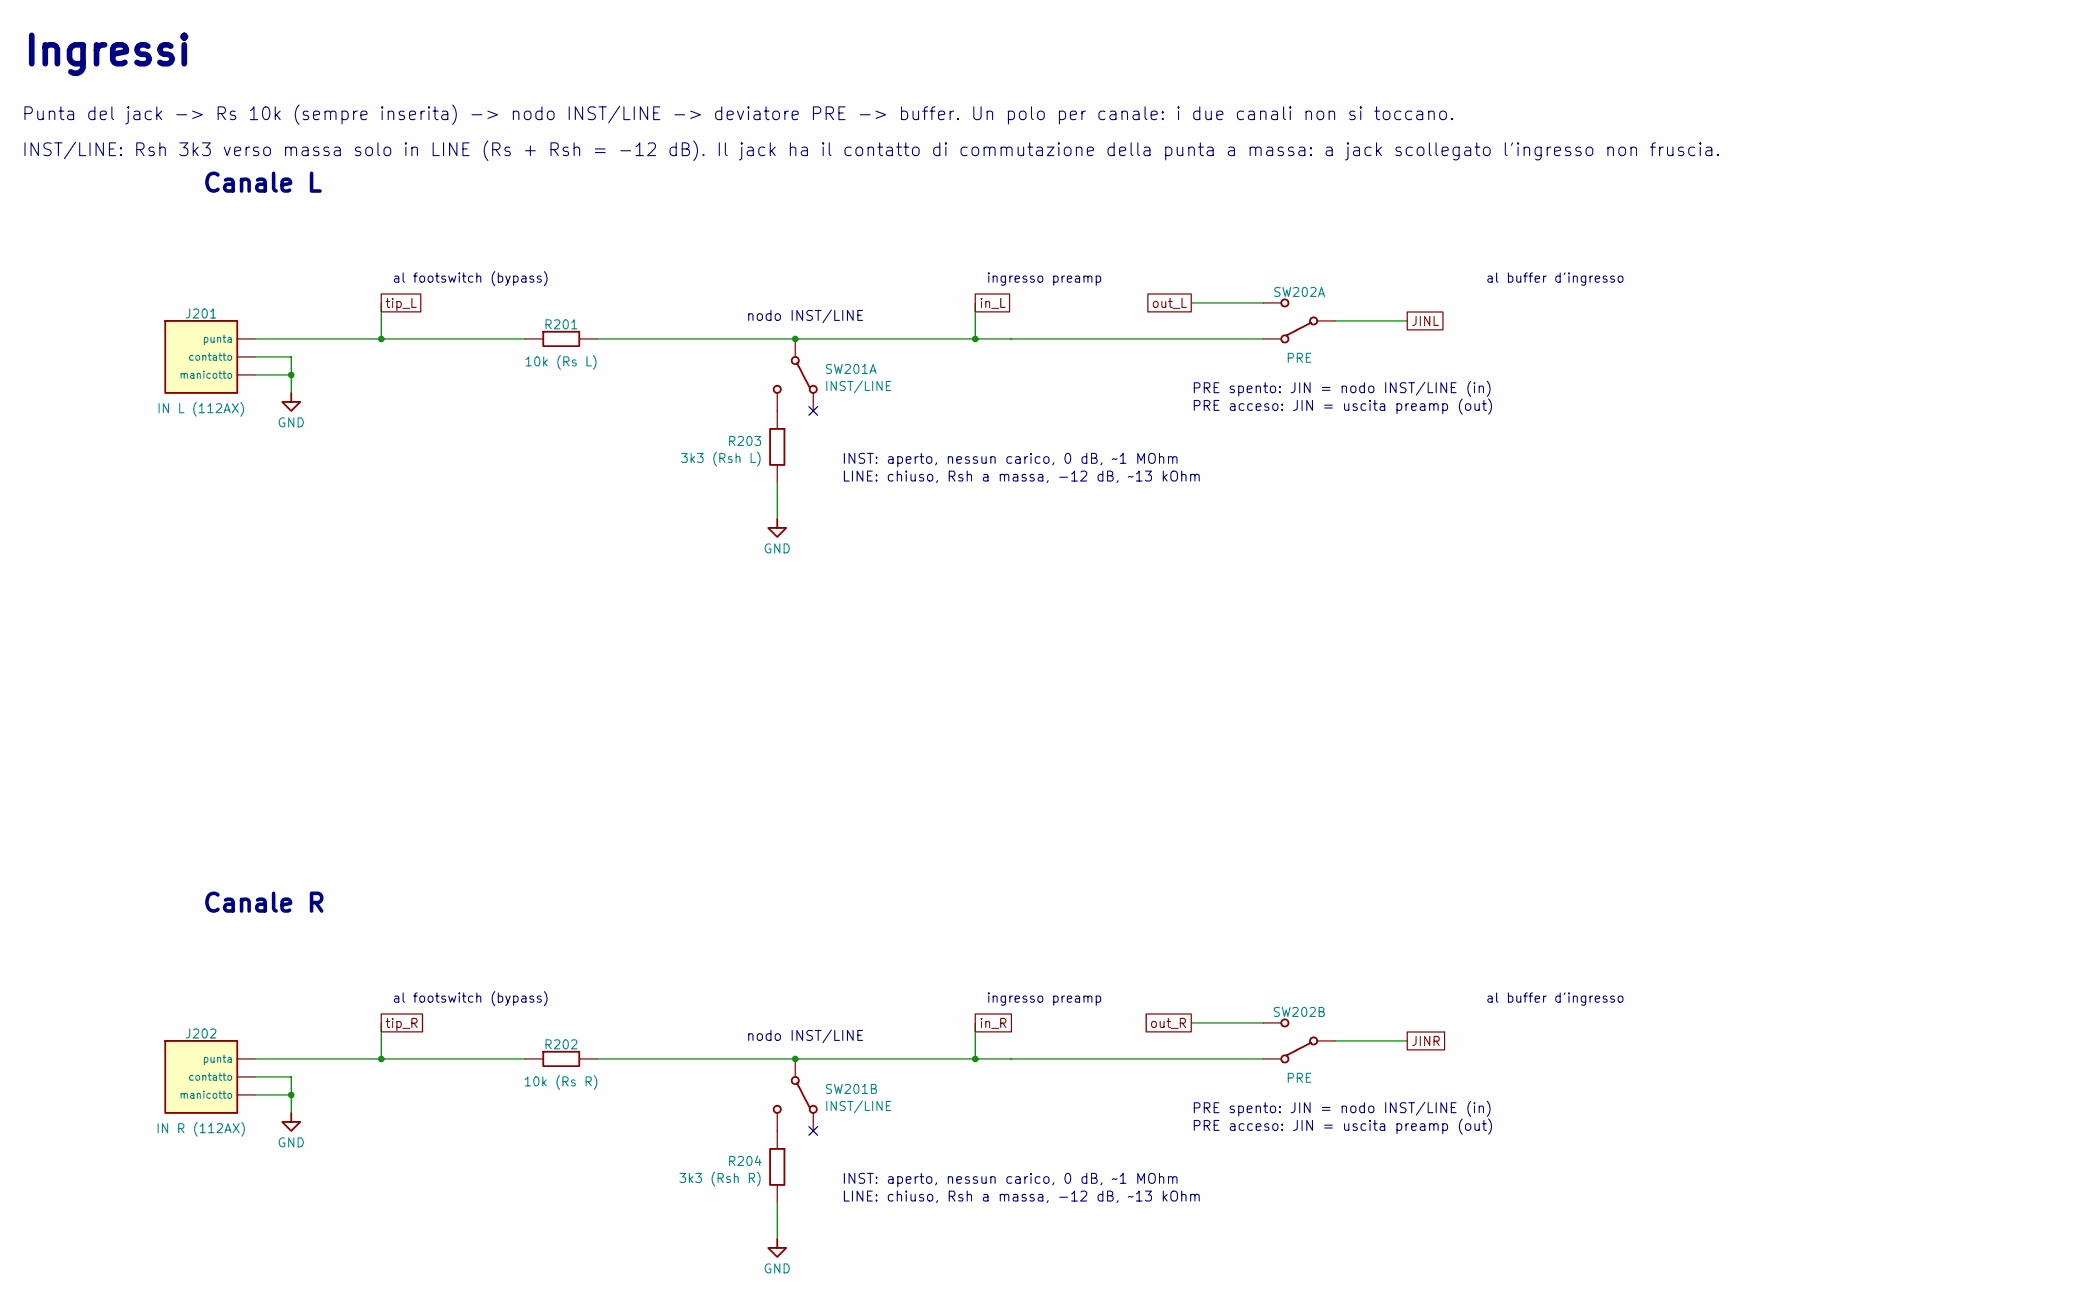
[picture p15: schematic f02_ingressi.kicad_sch]

Parts:
J201: IN L (112AX)
J202: IN R (112AX)
R201: 10k (Rs L)
R202: 10k (Rs R)
R203: 3k3 (Rsh L)
R204: 3k3 (Rsh R)
SW201: INST/LINE
SW202: PRE

Connections:
GND: J201.S (manicotto), J201.TN (contatto), J202.S (manicotto), J202.TN (contatto), R203.2, R204.2
JINL: SW202.2
JINR: SW202.5
unnamed: R203.1, SW201.3
unnamed: R204.1, SW201.6
in_L: R201.2, SW201.2, SW202.1
in_R: R202.2, SW201.5, SW202.4
out_L: SW202.3
out_R: SW202.6
tip_L: J201.T (punta), R201.1
tip_R: J202.T (punta), R202.1

Notes on the sheet:
Ingressi
Punta del jack -> Rs 10k (sempre inserita) -> nodo INST/LINE -> deviatore PRE -> buffer. Un polo per canale: i due canali non si toccano.
INST/LINE: Rsh 3k3 verso massa solo in LINE (Rs + Rsh = -12 dB). Il jack ha il contatto di commutazione della punta a massa: a jack scollegato l'ingresso non fruscia.
Canale L
al footswitch (bypass)
INST: aperto, nessun carico, 0 dB, ~1 MOhm
LINE: chiuso, Rsh a massa, -12 dB, ~13 kOhm
nodo INST/LINE
ingresso preamp
PRE spento: JIN = nodo INST/LINE (in)
PRE acceso: JIN = uscita preamp (out)
al buffer d'ingresso
Canale R
