pointlessaudio/PA_Telaio/hardware/kicad/f03_preamp.kicad_sch

## KiCad design hardware/kicad/f03_preamp.kicad_sch (2026-10-29)

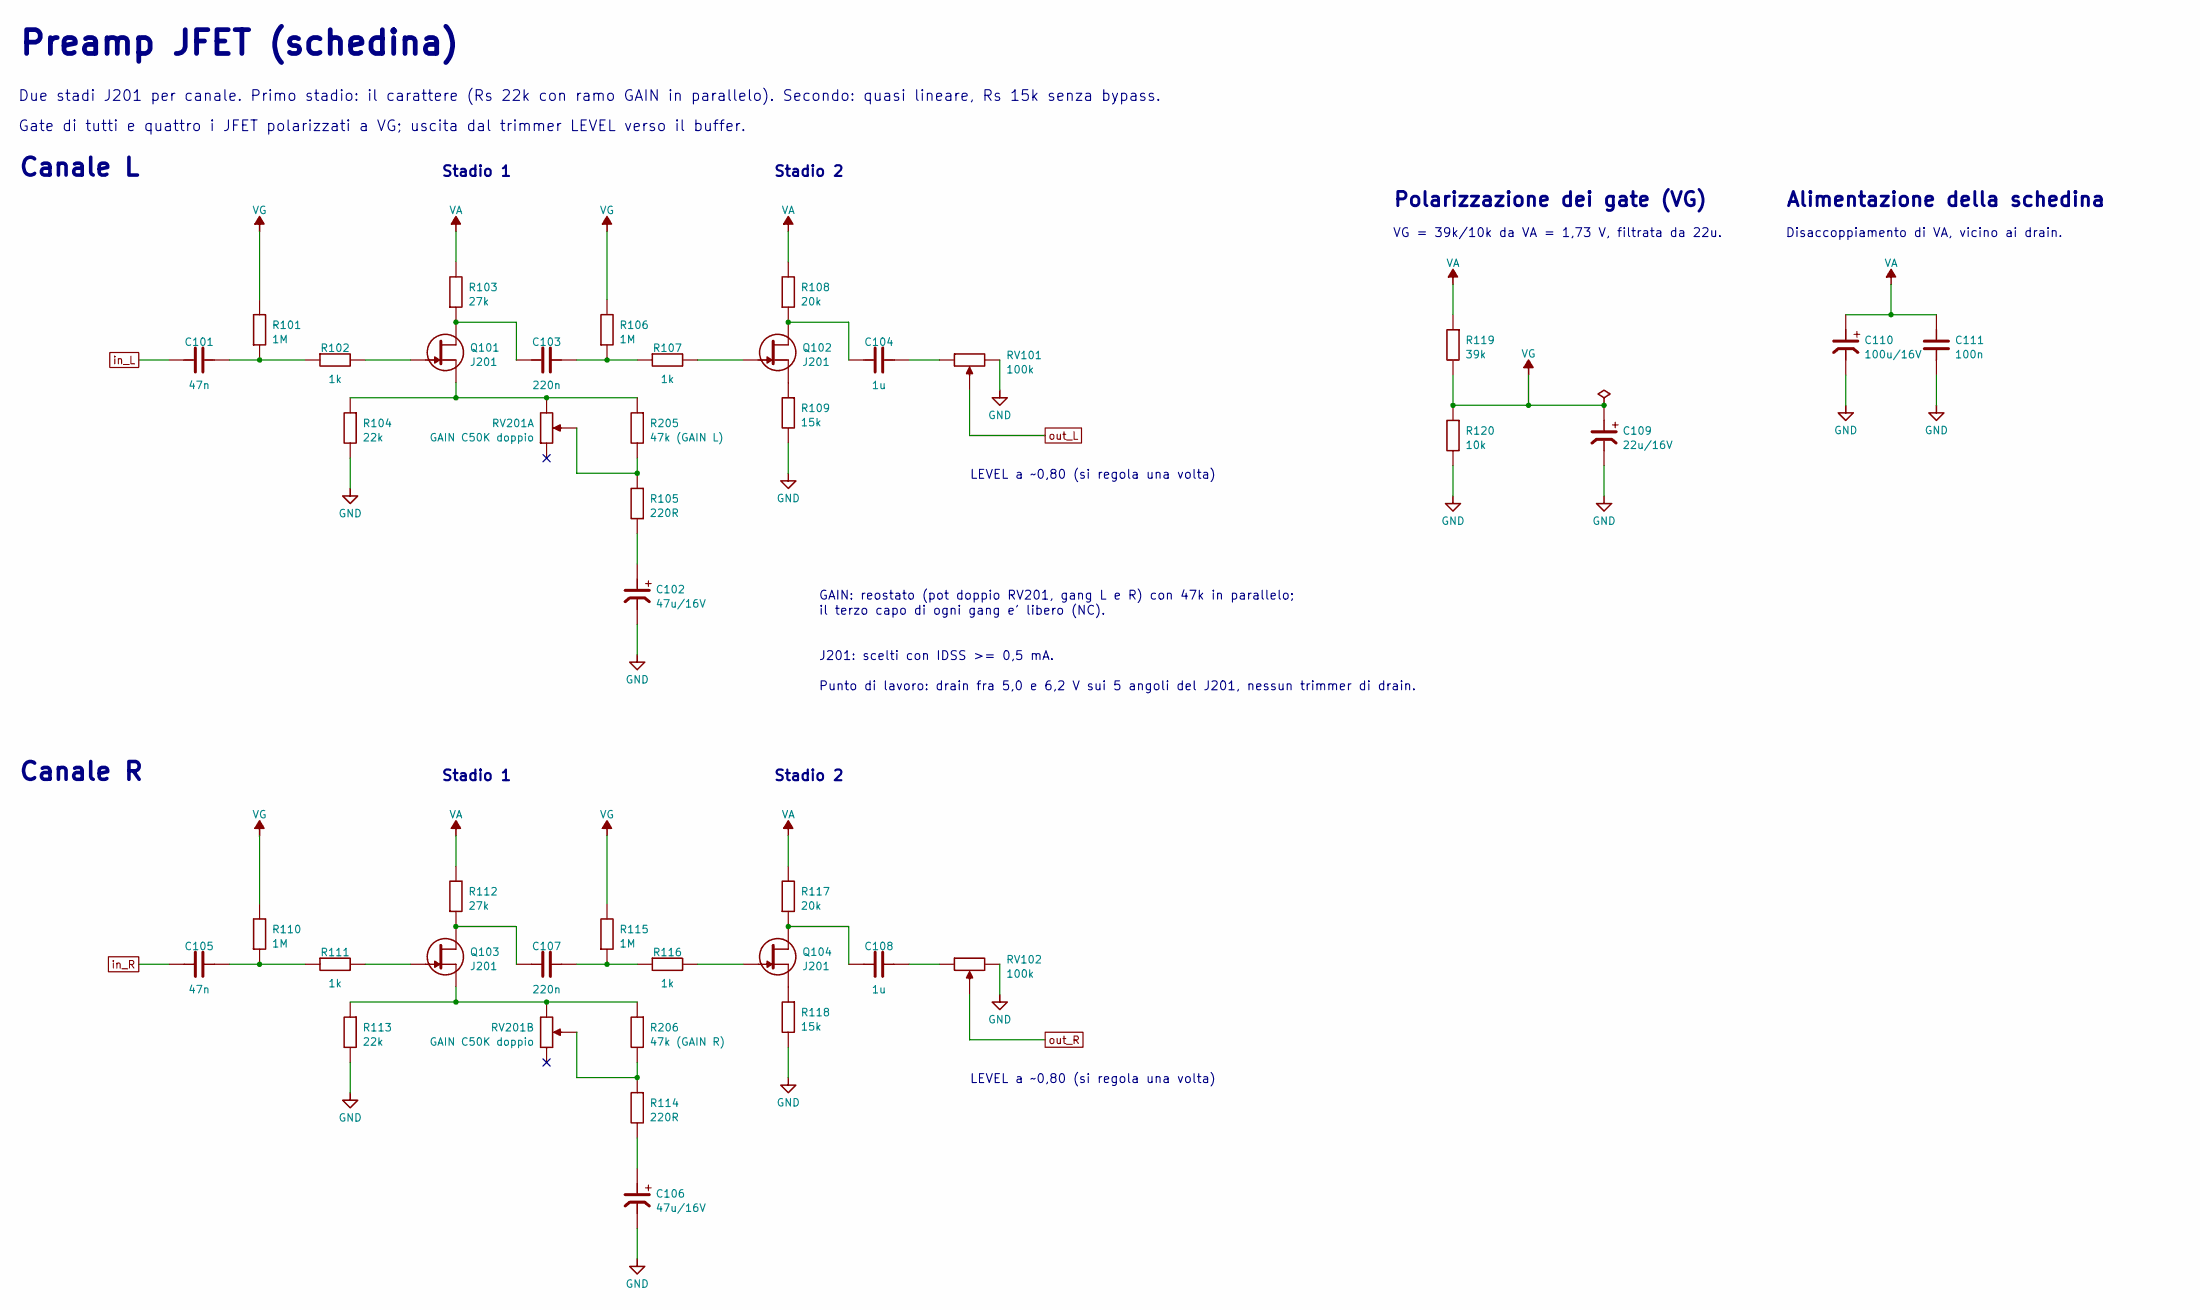
[picture p16: schematic f03_preamp.kicad_sch]

Parts:
C101, C105: 47n; C_Rect_L7.2mm_W3.5mm_P5.00mm_FKS2_FKP2_MKS2_MKP2
C102, C106: 47u/16V; CP_Radial_D5.0mm_P2.50mm
C103, C107: 220n; C_Rect_L7.2mm_W3.5mm_P5.00mm_FKS2_FKP2_MKS2_MKP2
C104, C108: 1u; C_Rect_L7.2mm_W3.5mm_P5.00mm_FKS2_FKP2_MKS2_MKP2
C109: 22u/16V; CP_Radial_D5.0mm_P2.50mm
C110: 100u/16V; CP_Radial_D5.0mm_P2.50mm
C111: 100n; C_Disc_D5.0mm_W2.5mm_P2.50mm
Q101, Q102, Q103, Q104: J201; TO-92_Inline
R101, R106, R110, R115: 1M; R_Axial_DIN0207_L6.3mm_D2.5mm_P7.62mm_Horizontal
R102, R107, R111, R116: 1k; R_Axial_DIN0207_L6.3mm_D2.5mm_P7.62mm_Horizontal
R103, R112: 27k; R_Axial_DIN0207_L6.3mm_D2.5mm_P7.62mm_Horizontal
R104, R113: 22k; R_Axial_DIN0207_L6.3mm_D2.5mm_P7.62mm_Horizontal
R105, R114: 220R; R_Axial_DIN0207_L6.3mm_D2.5mm_P7.62mm_Horizontal
R108, R117: 20k; R_Axial_DIN0207_L6.3mm_D2.5mm_P7.62mm_Horizontal
R109, R118: 15k; R_Axial_DIN0207_L6.3mm_D2.5mm_P7.62mm_Horizontal
R119: 39k; R_Axial_DIN0207_L6.3mm_D2.5mm_P7.62mm_Horizontal
R120: 10k; R_Axial_DIN0207_L6.3mm_D2.5mm_P7.62mm_Horizontal
R205: 47k (GAIN L)
R206: 47k (GAIN R)
RV101, RV102: 100k; Potentiometer_Bourns_3296W_Vertical
RV201: GAIN C50K doppio

Connections:
GND: C102.2 (-), C106.2 (-), C109.2 (-), C110.2 (-), C111.2, R104.2, R109.2, R113.2, R118.2, R120.2, RV101.3, RV102.3
unnamed: C101.2, R101.1, R102.1
unnamed: C102.1 (+), R105.2
unnamed: C103.1, Q101.1 (D), R103.1
unnamed: C103.2, R106.1, R107.1
unnamed: C104.1, Q102.1 (D), R108.1
unnamed: C104.2, RV101.1
unnamed: C105.2, R110.1, R111.1
unnamed: C106.1 (+), R114.2
unnamed: C107.1, Q103.1 (D), R112.1
unnamed: C107.2, R115.1, R116.1
unnamed: C108.1, Q104.1 (D), R117.1
unnamed: C108.2, RV102.1
unnamed: Q101.2 (S), R104.1, R205.1, RV201.3L
unnamed: Q101.3 (G), R102.2
unnamed: Q102.2 (S), R109.1
unnamed: Q102.3 (G), R107.2
unnamed: Q103.2 (S), R113.1, R206.1, RV201.3R
unnamed: Q103.3 (G), R111.2
unnamed: Q104.2 (S), R118.1
unnamed: Q104.3 (G), R116.2
unnamed: R105.1, R205.2, RV201.2L
unnamed: R114.1, R206.2, RV201.2R
VA: C110.1 (+), C111.1, R103.2, R108.2, R112.2, R117.2, R119.1
VG: C109.1 (+), R101.2, R106.2, R110.2, R115.2, R119.2, R120.1
in_L: C101.1
in_R: C105.1
out_L: RV101.2
out_R: RV102.2

Notes on the sheet:
Preamp JFET (schedina)
Due stadi J201 per canale. Primo stadio: il carattere (Rs 22k con ramo GAIN in parallelo). Secondo: quasi lineare, Rs 15k senza bypass.
Gate di tutti e quattro i JFET polarizzati a VG; uscita dal trimmer LEVEL verso il buffer.
Canale L
Canale R
Stadio 1
Stadio 2
GAIN: reostato (pot doppio RV201, gang L e R) con 47k in parallelo;
il terzo capo di ogni gang e' libero (NC).
J201: scelti con IDSS >= 0,5 mA.
Punto di lavoro: drain fra 5,0 e 6,2 V sui 5 angoli del J201, nessun trimmer di drain.
LEVEL a ~0,80 (si regola una volta)
Polarizzazione dei gate (VG)
VG = 39k/10k da VA = 1,73 V, filtrata da 22u.
Alimentazione della schedina
Disaccoppiamento di VA, vicino ai drain.
