pointlessaudio/PA_Telaio/hardware/kicad/f04_buffer_ingresso.kicad_sch

## KiCad design hardware/kicad/f04_buffer_ingresso.kicad_sch (2026-10-29)

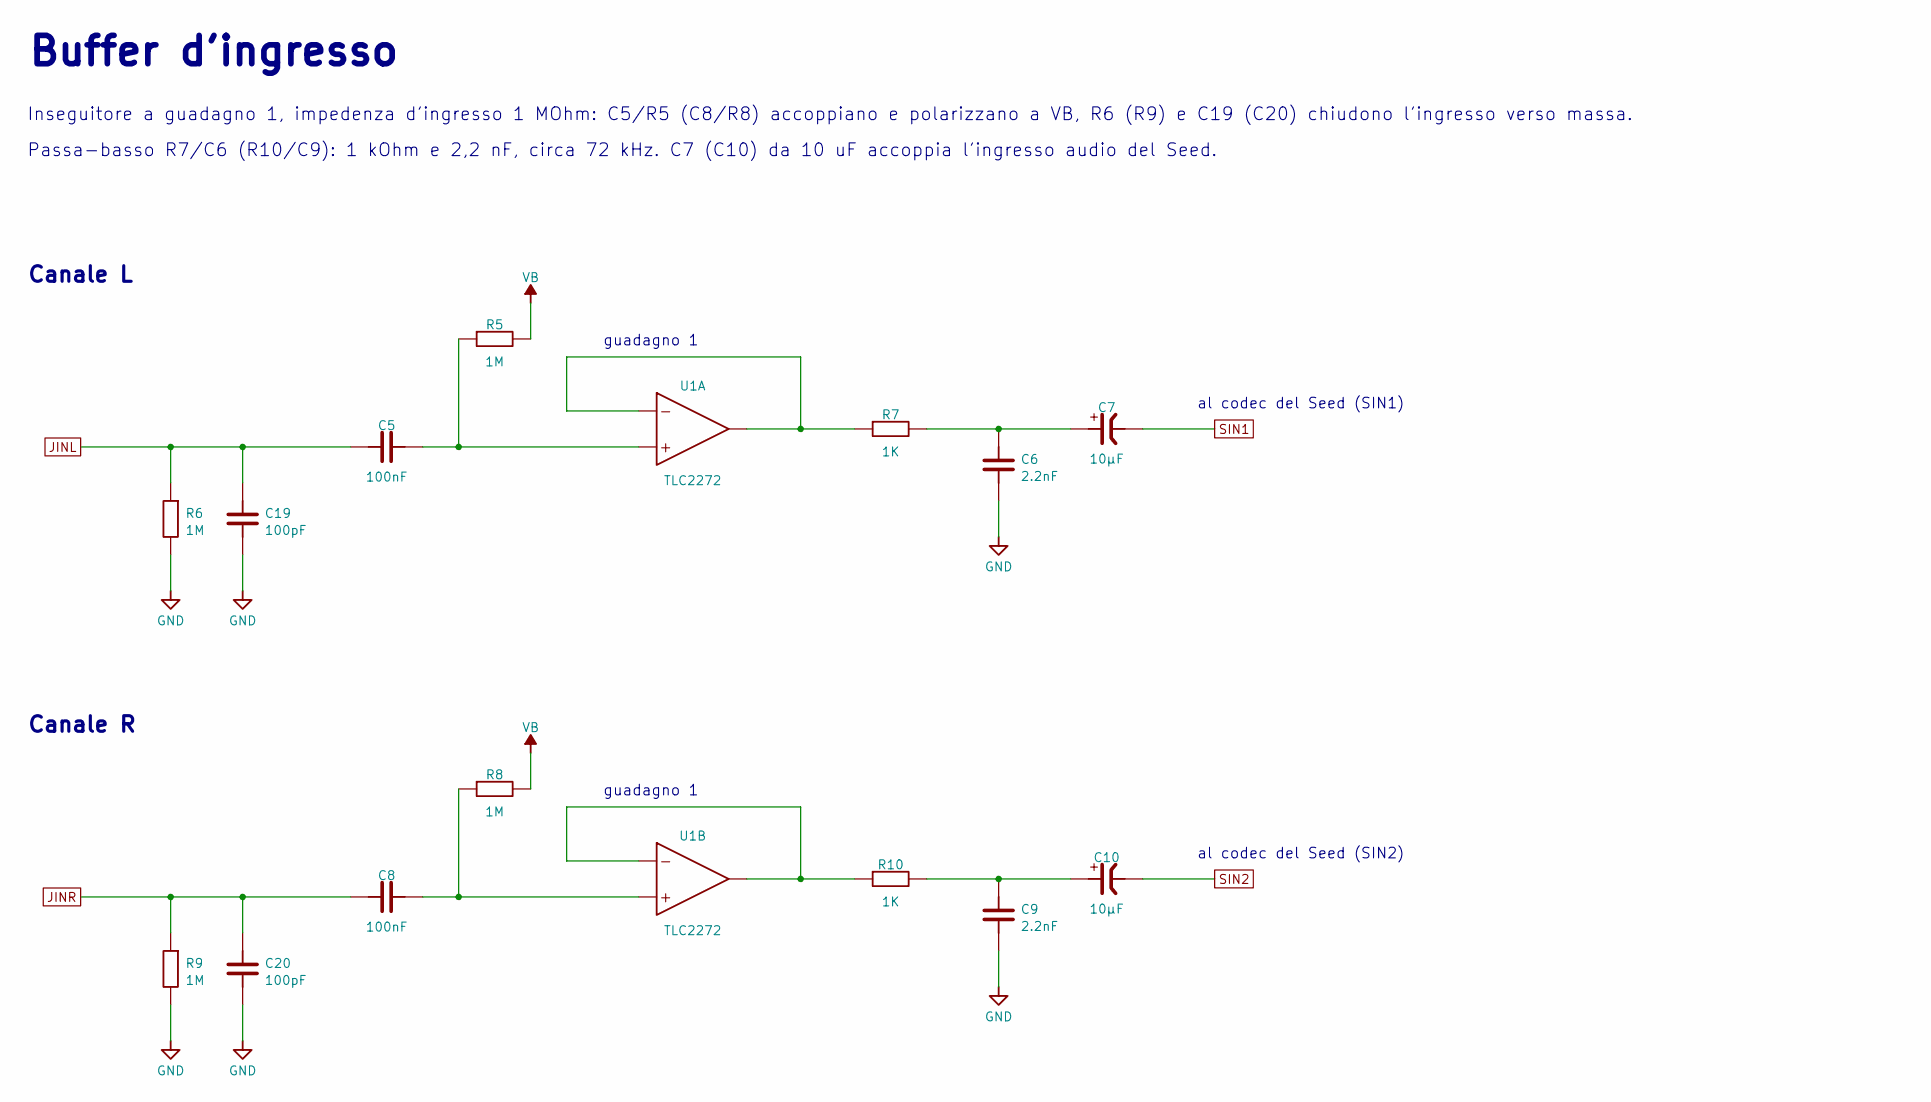
[picture p17: schematic f04_buffer_ingresso.kicad_sch]

Parts:
C5, C8: 100nF; C_Rect_L7.2mm_W3.5mm_P5.00mm_FKS2_FKP2_MKS2_MKP2
C6, C9: 2.2nF; C_Disc_D5.0mm_W2.5mm_P5.00mm
C7, C10: 10µF; CP_Radial_D5.0mm_P2.50mm
C19, C20: 100pF; C_Disc_D5.0mm_W2.5mm_P5.00mm
R5, R6, R8, R9: 1M; R_Axial_DIN0207_L6.3mm_D2.5mm_P7.62mm_Horizontal
R7, R10: 1K; R_Axial_DIN0207_L6.3mm_D2.5mm_P7.62mm_Horizontal
U1: TLC2272; DIP-8_W7.62mm_Socket

Connections:
GND: C6.2, C9.2, C19.2, C20.2, R6.2, R9.2
JINL: C5.1, C19.1, R6.1
JINR: C8.1, C20.1, R9.1
unnamed: C5.2, R5.1, U1.3 (+)
unnamed: C6.1, C7.1 (+), R7.2
unnamed: C8.2, R8.1, U1.5 (+)
unnamed: C9.1, C10.1 (+), R10.2
unnamed: R7.1, U1.1, U1.2 (-)
unnamed: R10.1, U1.6 (-), U1.7
SIN1: C7.2 (-)
SIN2: C10.2 (-)
VB: R5.2, R8.2

Notes on the sheet:
Buffer d'ingresso
Inseguitore a guadagno 1, impedenza d'ingresso 1 MOhm: C5/R5 (C8/R8) accoppiano e polarizzano a VB, R6 (R9) e C19 (C20) chiudono l'ingresso verso massa.
Passa-basso R7/C6 (R10/C9): 1 kOhm e 2,2 nF, circa 72 kHz. C7 (C10) da 10 uF accoppia l'ingresso audio del Seed.
Canale L
guadagno 1
al codec del Seed (SIN1)
Canale R
al codec del Seed (SIN2)
