pointlessaudio/PA_Telaio/hardware/kicad/f05_buffer_uscita.kicad_sch

## KiCad design hardware/kicad/f05_buffer_uscita.kicad_sch (2026-10-29)

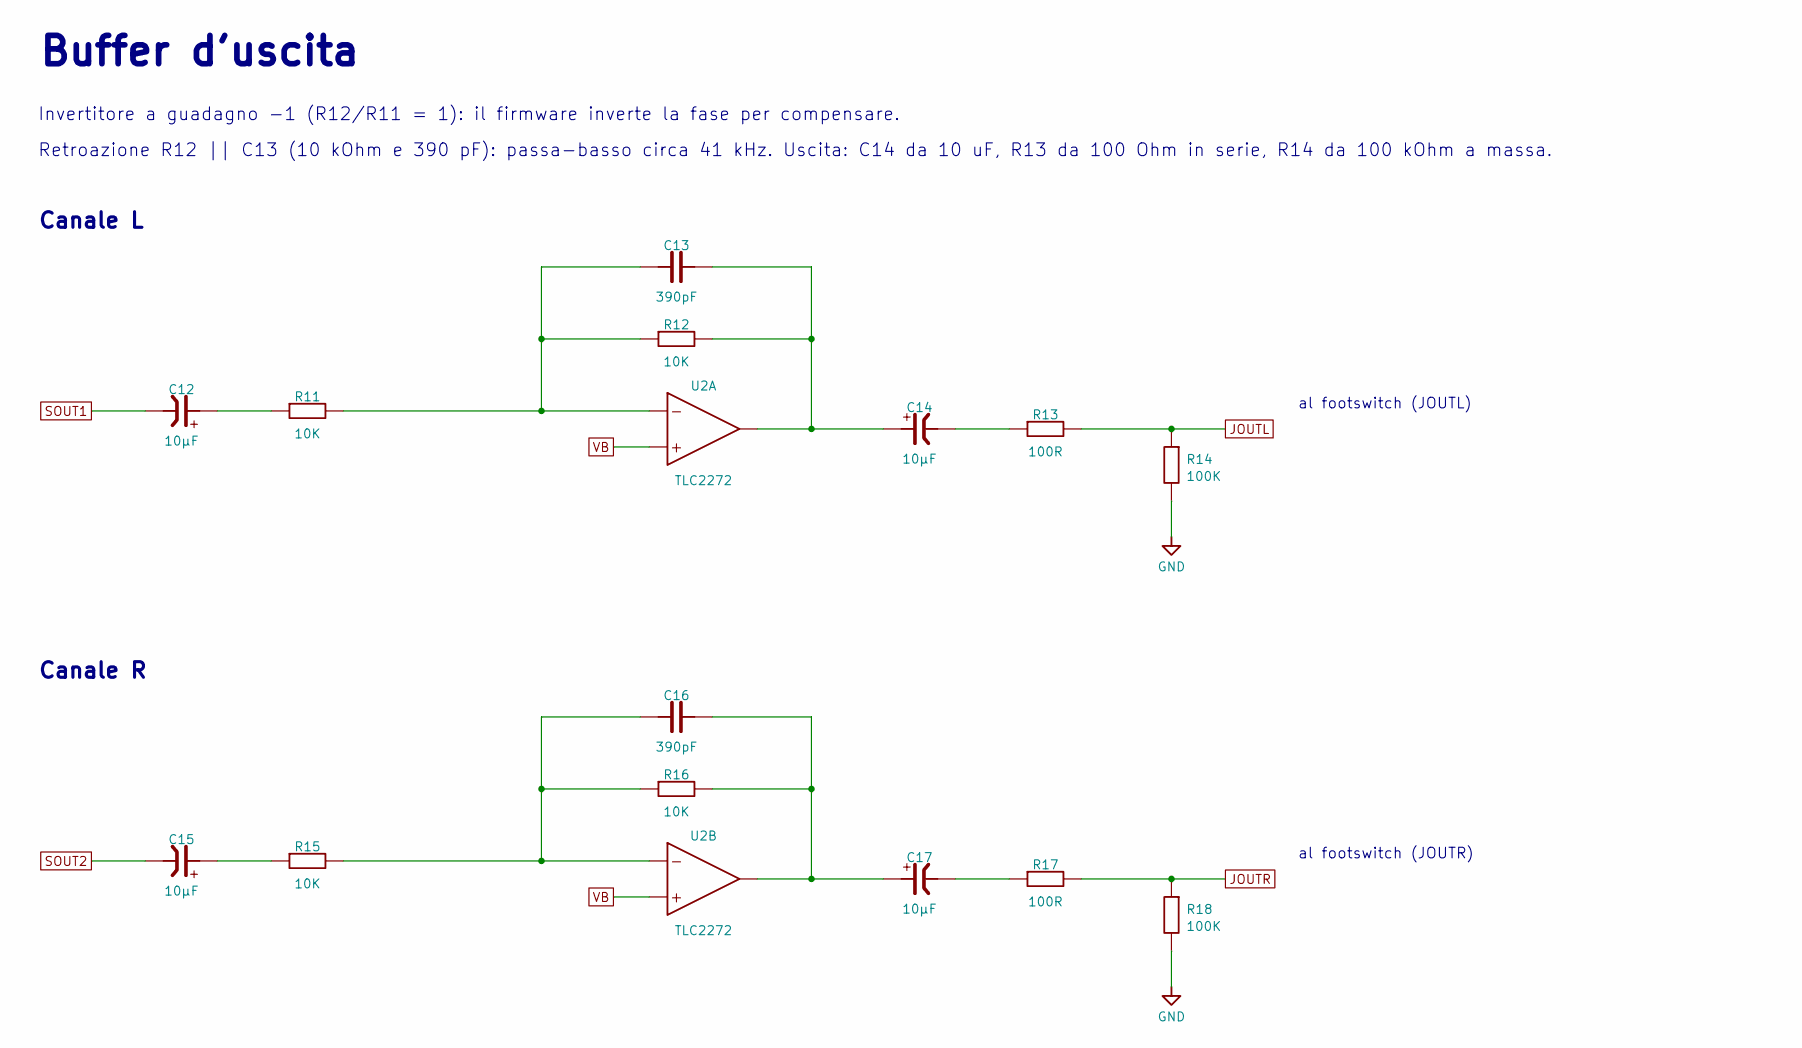
[picture p18: schematic f05_buffer_uscita.kicad_sch]

Parts:
C12, C14, C15, C17: 10µF; CP_Radial_D5.0mm_P2.50mm
C13, C16: 390pF; C_Disc_D5.0mm_W2.5mm_P5.00mm
R11, R12, R15, R16: 10K; R_Axial_DIN0207_L6.3mm_D2.5mm_P7.62mm_Horizontal
R13, R17: 100R; R_Axial_DIN0207_L6.3mm_D2.5mm_P7.62mm_Horizontal
R14, R18: 100K; R_Axial_DIN0207_L6.3mm_D2.5mm_P7.62mm_Horizontal
U2: TLC2272; DIP-8_W7.62mm_Socket

Connections:
GND: R14.2, R18.2
JOUTL: R13.2, R14.1
JOUTR: R17.2, R18.1
unnamed: C12.1 (+), R11.1
unnamed: C13.1, R11.2, R12.1, U2.2 (-)
unnamed: C13.2, C14.1 (+), R12.2, U2.1
unnamed: C14.2 (-), R13.1
unnamed: C15.1 (+), R15.1
unnamed: C16.1, R15.2, R16.1, U2.6 (-)
unnamed: C16.2, C17.1 (+), R16.2, U2.7
unnamed: C17.2 (-), R17.1
SOUT1: C12.2 (-)
SOUT2: C15.2 (-)
VB: U2.3 (+), U2.5 (+)

Notes on the sheet:
Buffer d'uscita
Invertitore a guadagno -1 (R12/R11 = 1): il firmware inverte la fase per compensare.
Retroazione R12 || C13 (10 kOhm e 390 pF): passa-basso circa 41 kHz. Uscita: C14 da 10 uF, R13 da 100 Ohm in serie, R14 da 100 kOhm a massa.
Canale L
al footswitch (JOUTL)
Canale R
al footswitch (JOUTR)
