pointlessaudio/PA_Telaio/hardware/kicad/f06_uscite.kicad_sch

## KiCad design hardware/kicad/f06_uscite.kicad_sch (2026-10-29)

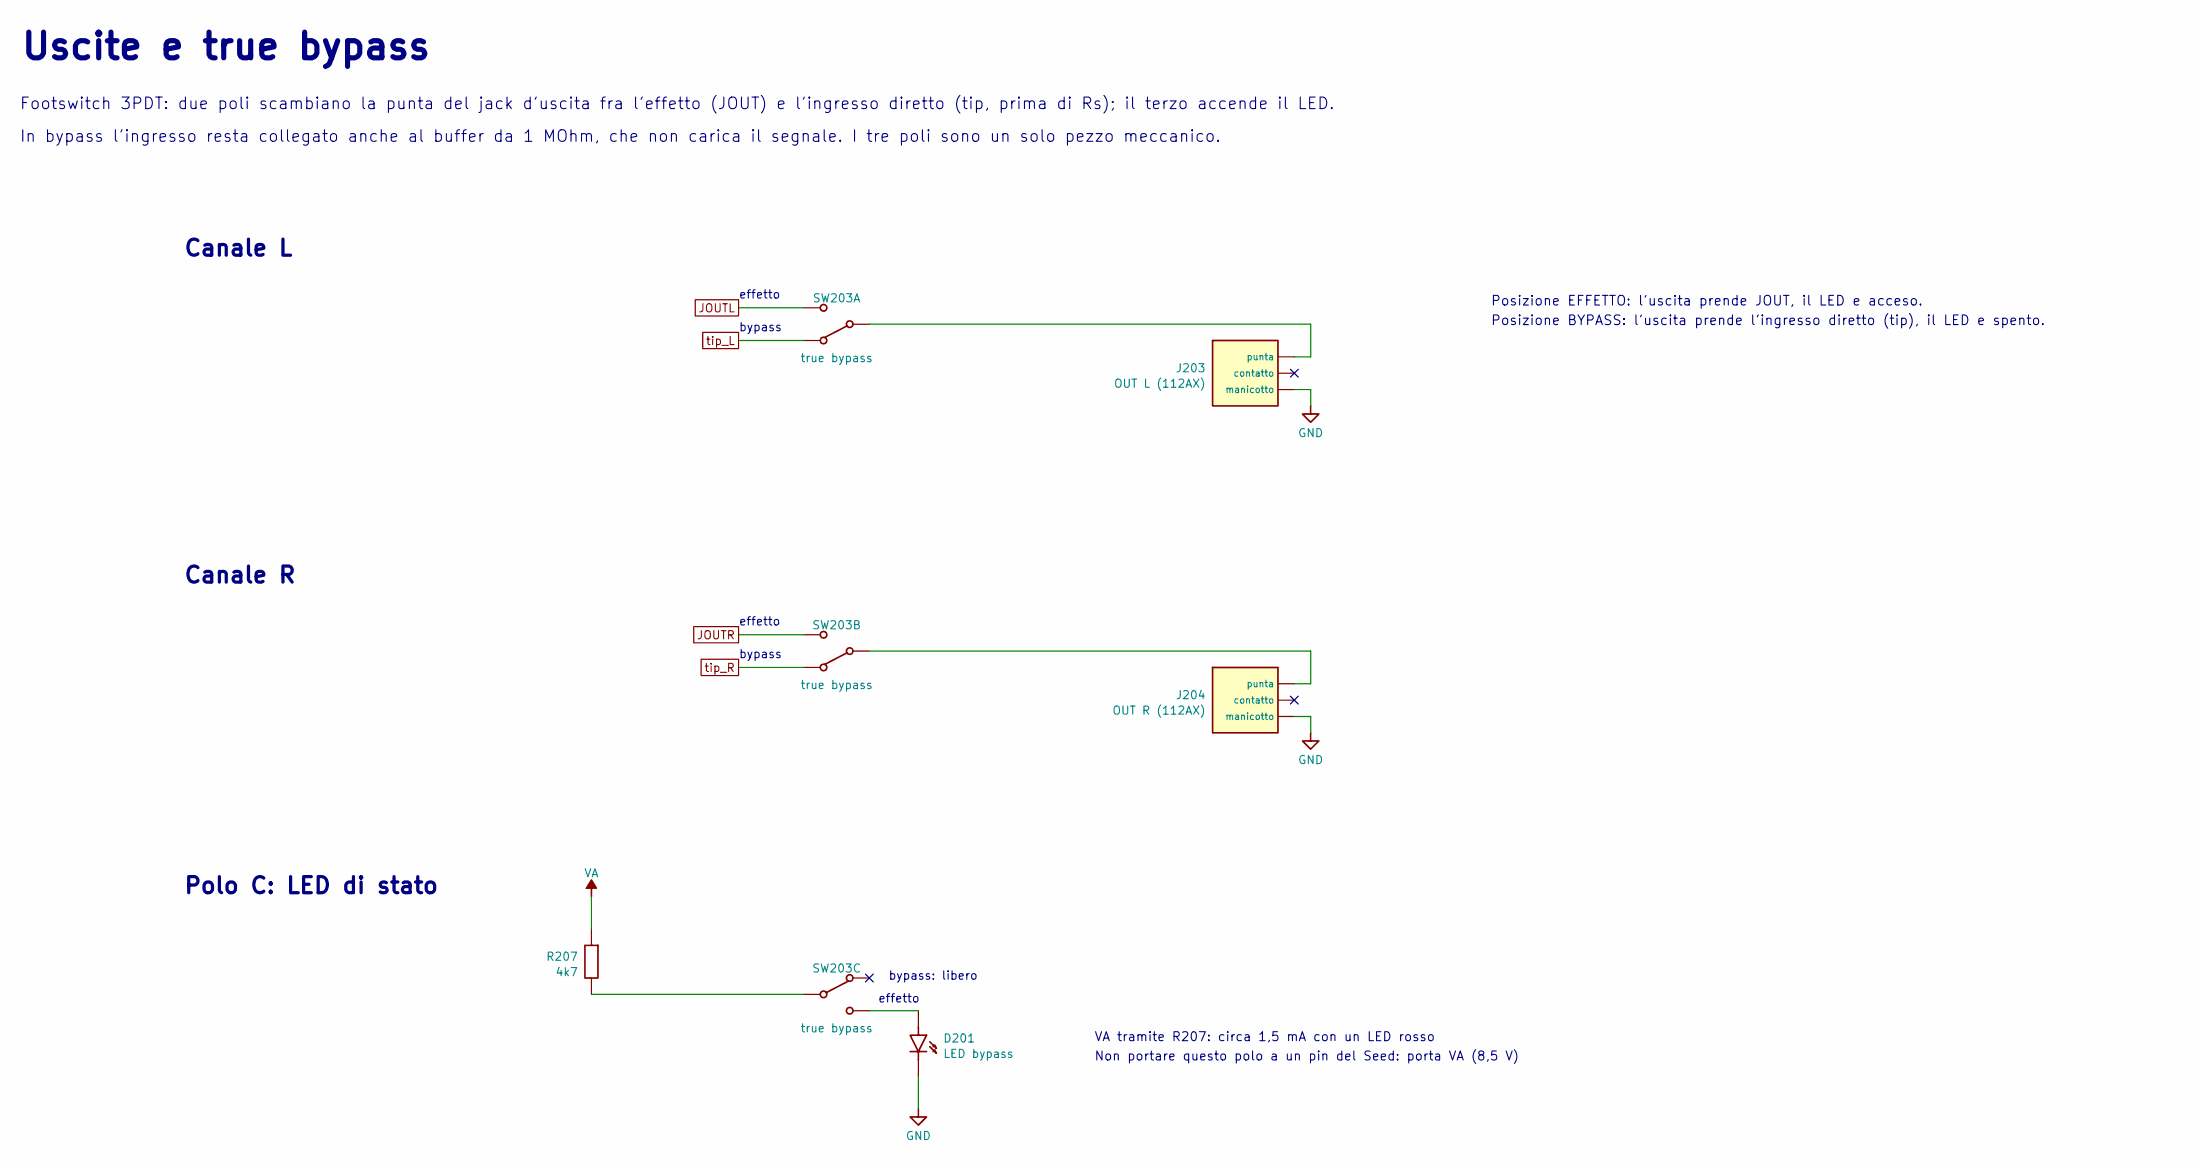
[picture p19: schematic f06_uscite.kicad_sch]

Parts:
D201: LED bypass
J203: OUT L (112AX)
J204: OUT R (112AX)
R207: 4k7
SW203: true bypass

Connections:
GND: D201.1 (K), J203.S (manicotto), J204.S (manicotto)
JOUTL: SW203.A3
JOUTR: SW203.B3
unnamed: D201.2 (A), SW203.C3
unnamed: J203.T (punta), SW203.A2
unnamed: J204.T (punta), SW203.B2
unnamed: R207.2, SW203.C2
VA: R207.1
tip_L: SW203.A1
tip_R: SW203.B1

Notes on the sheet:
Uscite e true bypass
Footswitch 3PDT: due poli scambiano la punta del jack d'uscita fra l'effetto (JOUT) e l'ingresso diretto (tip, prima di Rs); il terzo accende il LED.
In bypass l'ingresso resta collegato anche al buffer da 1 MOhm, che non carica il segnale. I tre poli sono un solo pezzo meccanico.
Canale L
effetto
bypass
Canale R
Polo C: LED di stato
bypass: libero
VA tramite R207: circa 1,5 mA con un LED rosso
Non portare questo polo a un pin del Seed: porta VA (8,5 V)
Posizione EFFETTO: l'uscita prende JOUT, il LED e acceso.
Posizione BYPASS: l'uscita prende l'ingresso diretto (tip), il LED e spento.
