pointlessaudio/PA_Telaio/hardware/kicad/f08_controlli.kicad_sch

## KiCad design hardware/kicad/f08_controlli.kicad_sch (2026-10-29)

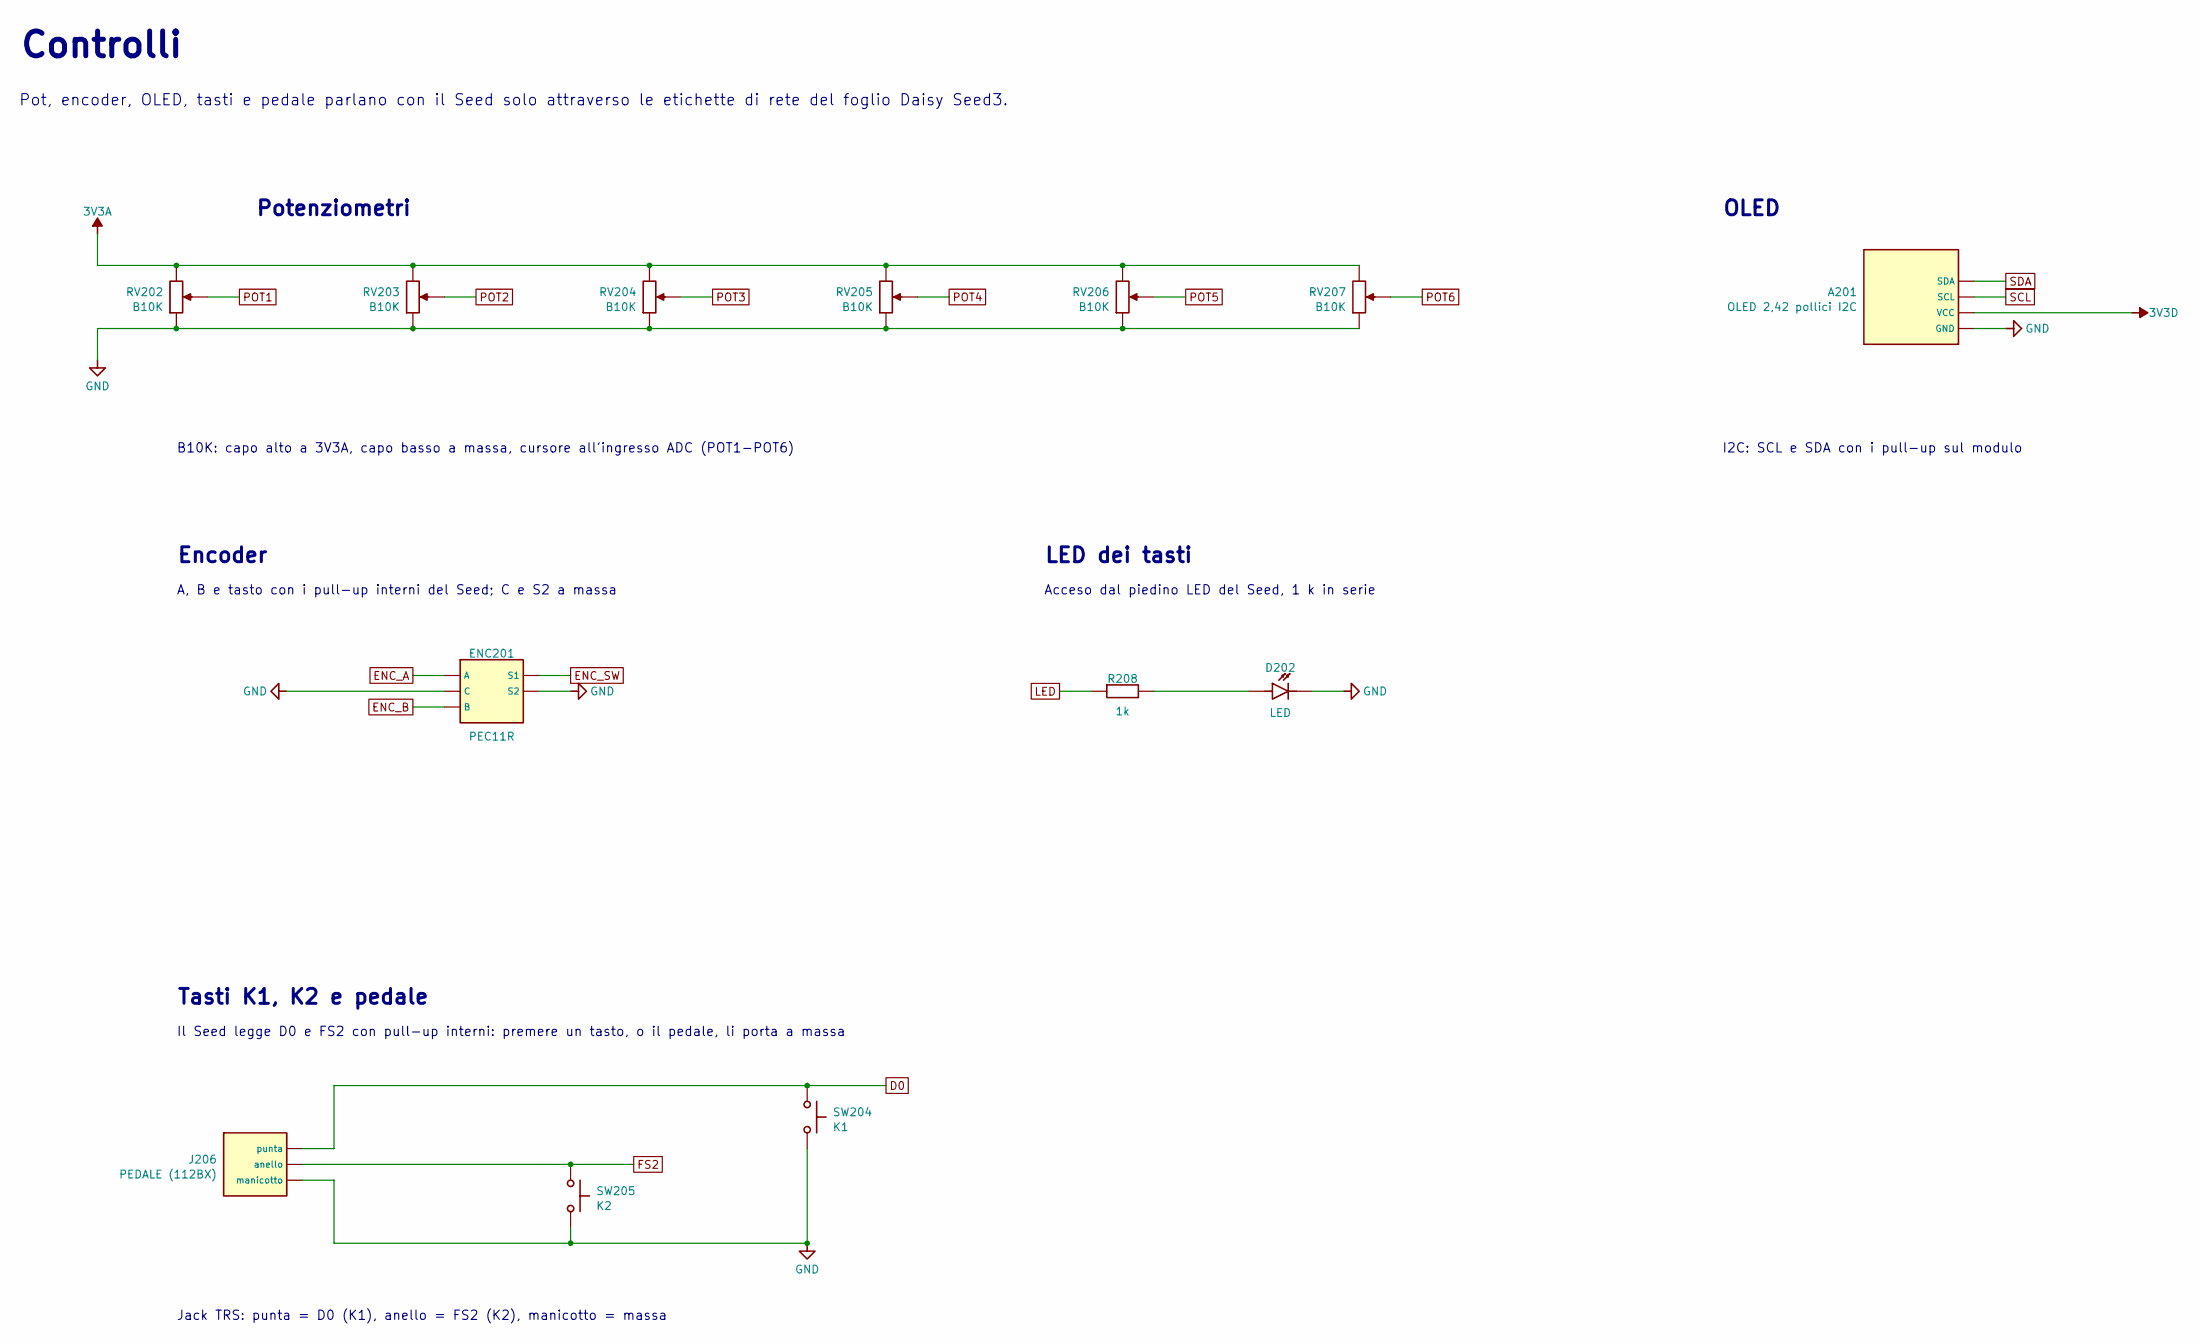
[picture p20: schematic f08_controlli.kicad_sch]

Parts:
A201: OLED 2,42 pollici I2C
D202: LED
ENC201: PEC11R
J206: PEDALE (112BX)
R208: 1k
RV202, RV203, RV204, RV205, RV206, RV207: B10K
SW204: K1
SW205: K2

Connections:
3V3A: RV202.3, RV203.3, RV204.3, RV205.3, RV206.3, RV207.3
3V3D: A201.2 (VCC)
D0: J206.T (punta), SW204.1
ENC_A: ENC201.A
ENC_B: ENC201.B
ENC_SW: ENC201.S1
FS2: J206.R (anello), SW205.1
GND: A201.1 (GND), D202.1 (K), ENC201.C, ENC201.S2, J206.S (manicotto), RV202.1, RV203.1, RV204.1, RV205.1, RV206.1, RV207.1, SW204.2, SW205.2
LED: R208.1
unnamed: D202.2 (A), R208.2
POT1: RV202.2
POT2: RV203.2
POT3: RV204.2
POT4: RV205.2
POT5: RV206.2
POT6: RV207.2
SCL: A201.3 (SCL)
SDA: A201.4 (SDA)

Notes on the sheet:
Controlli
Pot, encoder, OLED, tasti e pedale parlano con il Seed solo attraverso le etichette di rete del foglio Daisy Seed3.
Potenziometri
B10K: capo alto a 3V3A, capo basso a massa, cursore all'ingresso ADC (POT1-POT6)
OLED
I2C: SCL e SDA con i pull-up sul modulo
Encoder
A, B e tasto con i pull-up interni del Seed; C e S2 a massa
LED dei tasti
Acceso dal piedino LED del Seed, 1 k in serie
Tasti K1, K2 e pedale
Il Seed legge D0 e FS2 con pull-up interni: premere un tasto, o il pedale, li porta a massa
Jack TRS: punta = D0 (K1), anello = FS2 (K2), manicotto = massa
