pointlessaudio/PA_Telaio/hardware/kicad/f09_midi_sd.kicad_sch

## KiCad design hardware/kicad/f09_midi_sd.kicad_sch (2026-10-29)

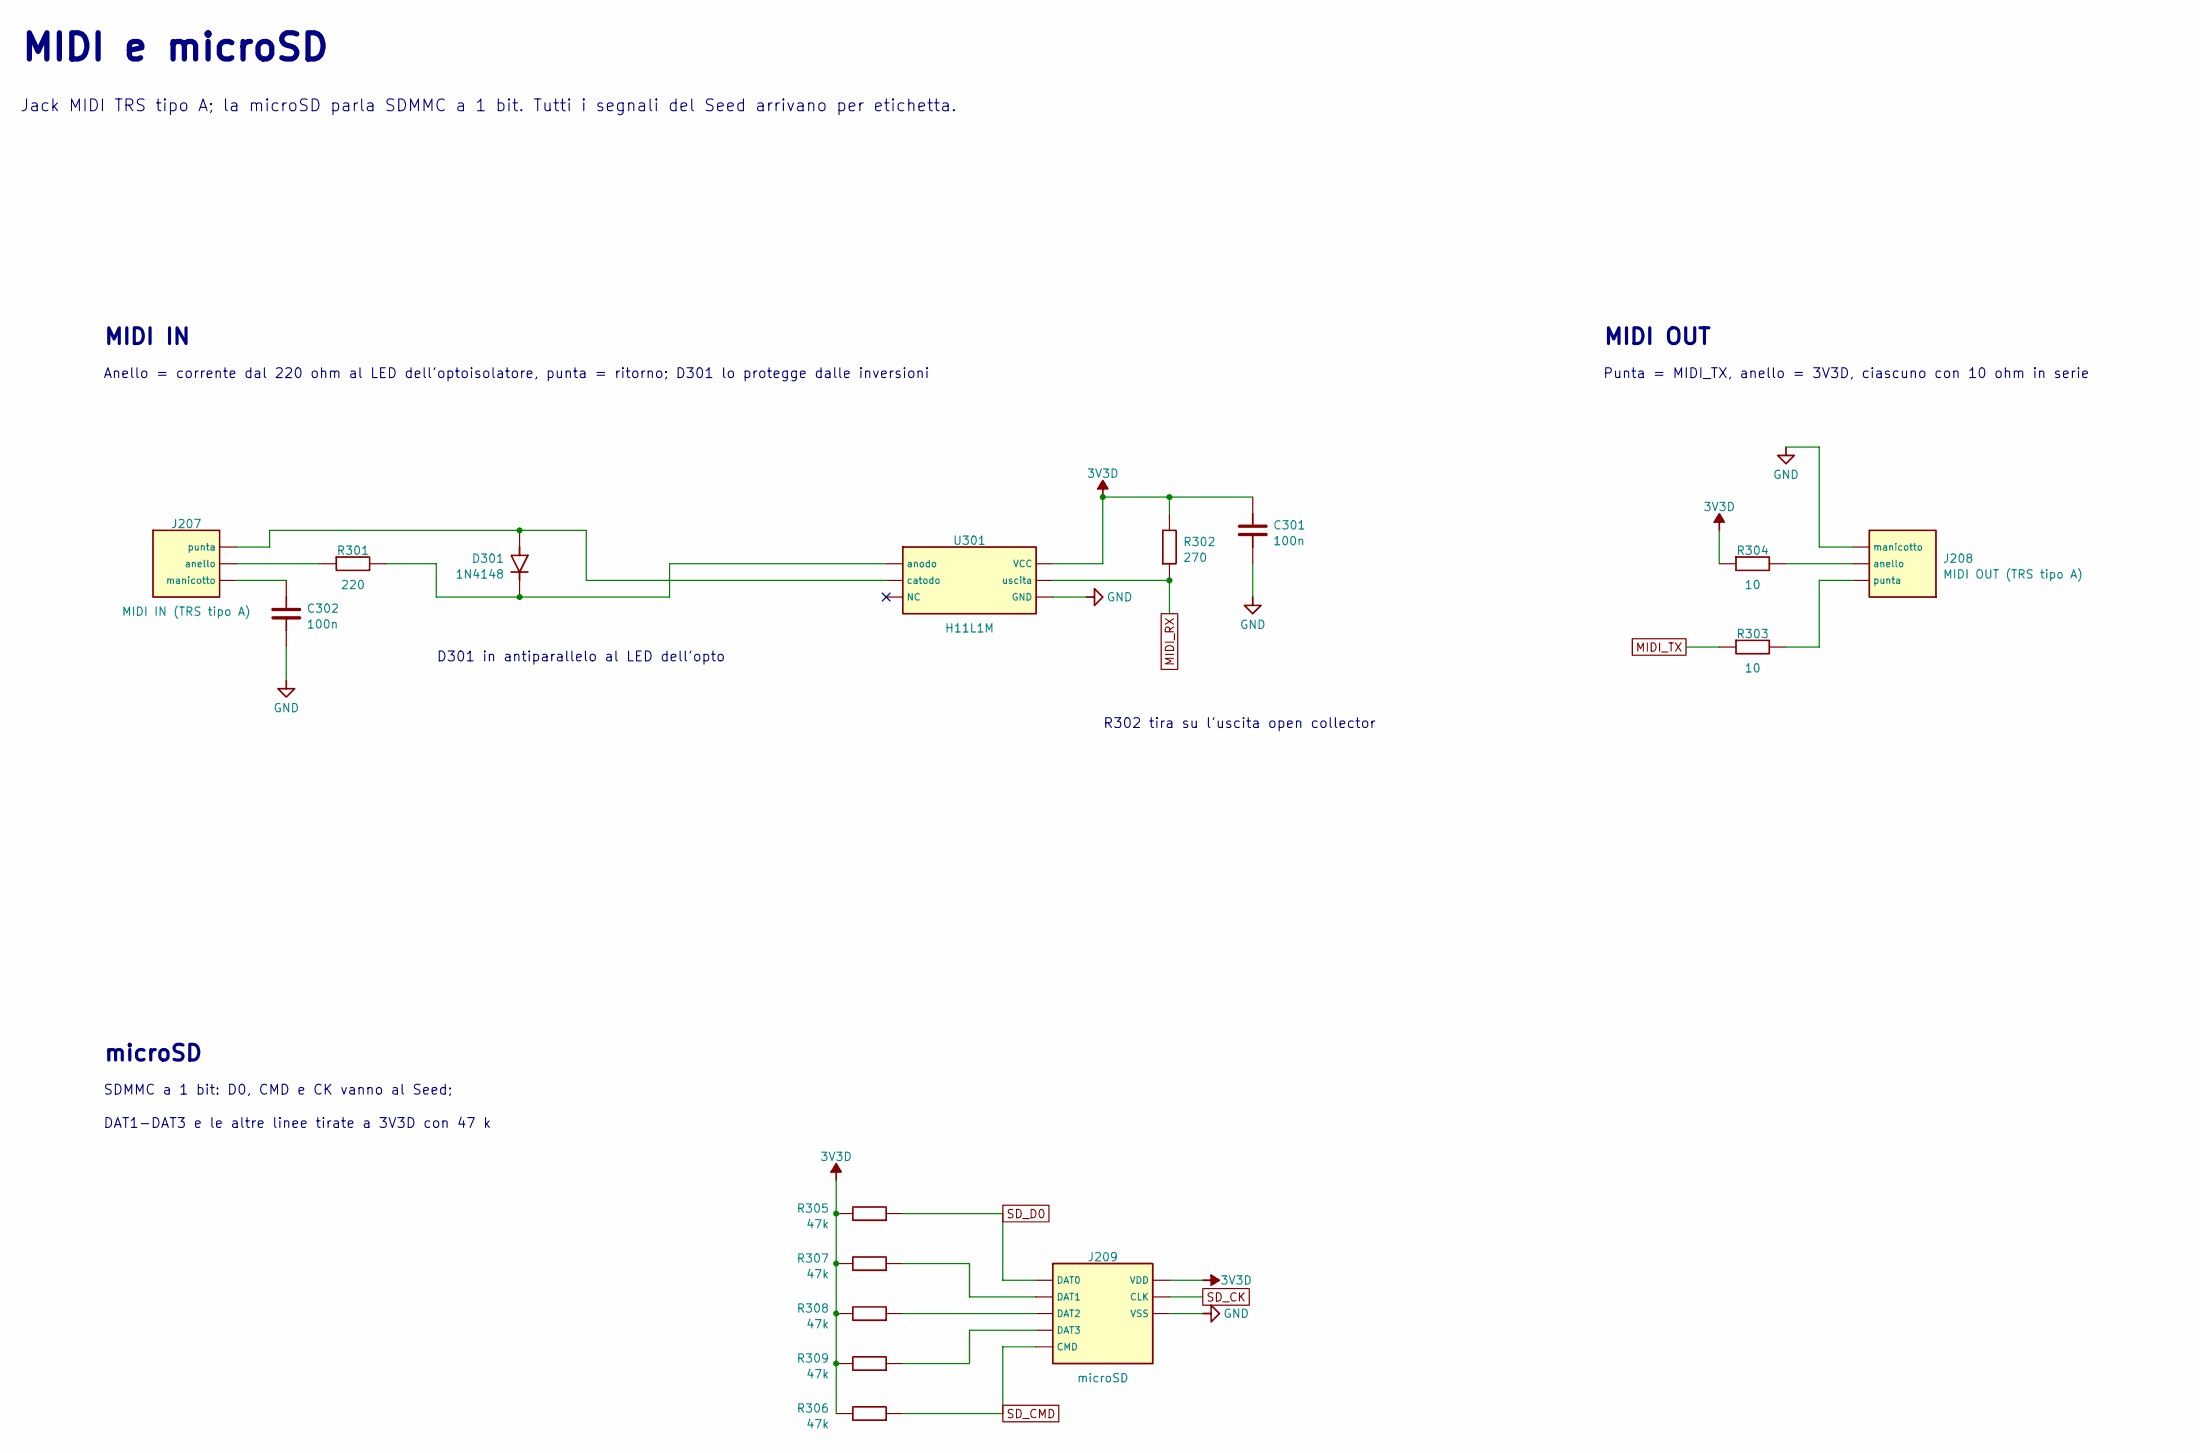
[picture p21: schematic f09_midi_sd.kicad_sch]

Parts:
C301, C302: 100n
D301: 1N4148
J207: MIDI IN (TRS tipo A)
J208: MIDI OUT (TRS tipo A)
J209: microSD
R301: 220
R302: 270
R303, R304: 10
R305, R306, R307, R308, R309: 47k
U301: H11L1M

Connections:
3V3D: C301.1, J209.4 (VDD), R302.2, R304.1, R305.2, R306.2, R307.2, R308.2, R309.2, U301.6 (VCC)
GND: C301.2, C302.2, J208.S (manicotto), J209.6 (VSS), U301.5 (GND)
MIDI_RX: R302.1, U301.4 (uscita)
MIDI_TX: R303.1
unnamed: C302.1, J207.S (manicotto)
unnamed: D301.1 (K), R301.2, U301.1 (anodo)
unnamed: D301.2 (A), J207.T (punta), U301.2 (catodo)
unnamed: J207.R (anello), R301.1
unnamed: J208.R (anello), R304.2
unnamed: J208.T (punta), R303.2
unnamed: J209.1 (DAT2), R308.1
unnamed: J209.2 (DAT3), R309.1
unnamed: J209.8 (DAT1), R307.1
SD_CK: J209.5 (CLK)
SD_CMD: J209.3 (CMD), R306.1
SD_D0: J209.7 (DAT0), R305.1

Notes on the sheet:
MIDI e microSD
Jack MIDI TRS tipo A; la microSD parla SDMMC a 1 bit. Tutti i segnali del Seed arrivano per etichetta.
MIDI IN
Anello = corrente dal 220 ohm al LED dell'optoisolatore, punta = ritorno; D301 lo protegge dalle inversioni
D301 in antiparallelo al LED dell'opto
R302 tira su l'uscita open collector
MIDI OUT
Punta = MIDI_TX, anello = 3V3D, ciascuno con 10 ohm in serie
microSD
SDMMC a 1 bit: D0, CMD e CK vanno al Seed;
DAT1-DAT3 e le altre linee tirate a 3V3D con 47 k
