pointlessaudio/PA_Telaio/(commit log)

2026-10-29 PA-TELAIO: stato al 29/09 (veroboard verificata, case 3D parametrico e 1590DD, firmware di collaudo, ordine componenti)
    [PA-TELAIO_BOM.xlsx, PA_ordine_125b_Seed3.xlsx]
2026-10-29 Circuito: confronto veroboard, PCB JLCPCB, PCB fresata in casa
2026-10-29 Repo pubblico: README it/en, licenze CERN-OHL-S e MIT, marchio escluso, CLAUDE.md diviso in docs/, dati personali tolti
    - README.md e README.en.md per chi arriva da fuori
    - LICENSE: hardware CERN-OHL-S-2.0, firmware e script MIT, logo Pointless Audio escluso
    - CLAUDE.md ridotto: stato in docs/stato.md, documentazione tecnica in docs/progetto.md
    - logo in case/marchio/ (prima era fuori dal repo e case.py non girava altrove)
    - script di render non più esclusi da .gitignore
    - tolti codice di preventivo, link privati, percorsi del Mac
    [collaudo.cpp]
2026-10-29 Preamp JFET: spinta affinata (V4a), schedina su stripboard verificata, PRE e GAIN nel case, distinta, collaudo e documentazione
2026-10-29 Preamp: GAIN doppio C50K con 47k in parallelo per gang, J201 con IDSS >= 0,5 mA; simulazione, montaggio e distinta aggiornati
2026-10-29 Versione da stampare: parti reali nel case, cablaggio interno (78 fili), schermatura e masse a stella, G-code 29/10
2026-10-29 Decisione 5: deviatore PRE DPDT, ingresso a ~500 kΩ col PRE spento accettato
2026-10-29 Render del case del 29/10 (GAIN, PRE, massa L0, microSD) nei README; render in cartella datata
2026-10-29 Schema KiCad generato dalle netlist (127 componenti, 94 reti), verificato con la netlist di KiCad, ERC e 6 mutazioni
    [pa-telaio.kicad_sch]
2026-10-29 Schema KiCad disegnato: 10 pagine A3 con fili e un foglio per blocco, PDF; netlist verificata, ERC pulito, 6 mutazioni
    [f01_alimentazione.kicad_sch, f02_ingressi.kicad_sch, f03_preamp.kicad_sch, f04_buffer_ingresso.kicad_sch, f05_buffer_uscita.kicad_sch, f06_uscite.kicad_sch, f07_seed.kicad_sch, f08_controlli.kicad_sch]
